LiDRON7/Drone-Construction/README.md

# Drone Construction

LiDRON's drone models and the parts we 3D print for them. Two drones: Widow (test drone) and Huntsman (carries the LiDAR).

## Widow

Storm Drone 6 V3. Parts, sizes and weights: [Widow README](3D%20Models/Widow/README.md).

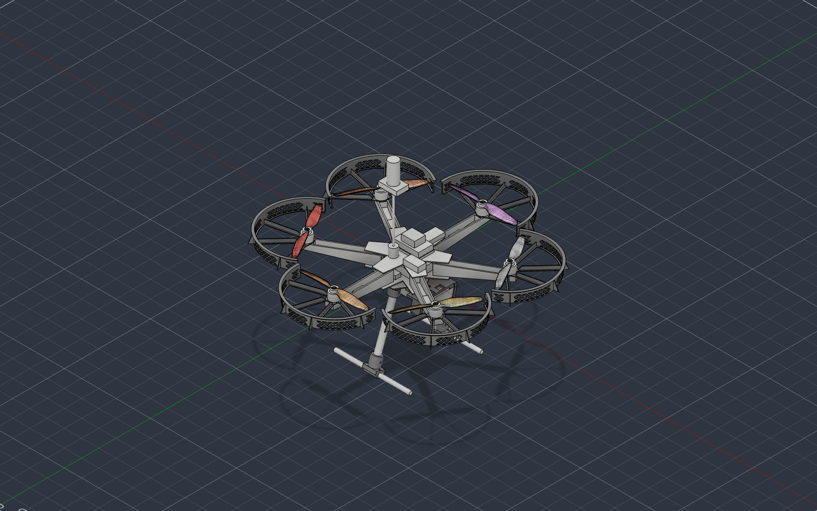
[picture p1: 3D Models/Widow/Full Drone/widow-full-drone-preview.png]
Widow, the whole drone
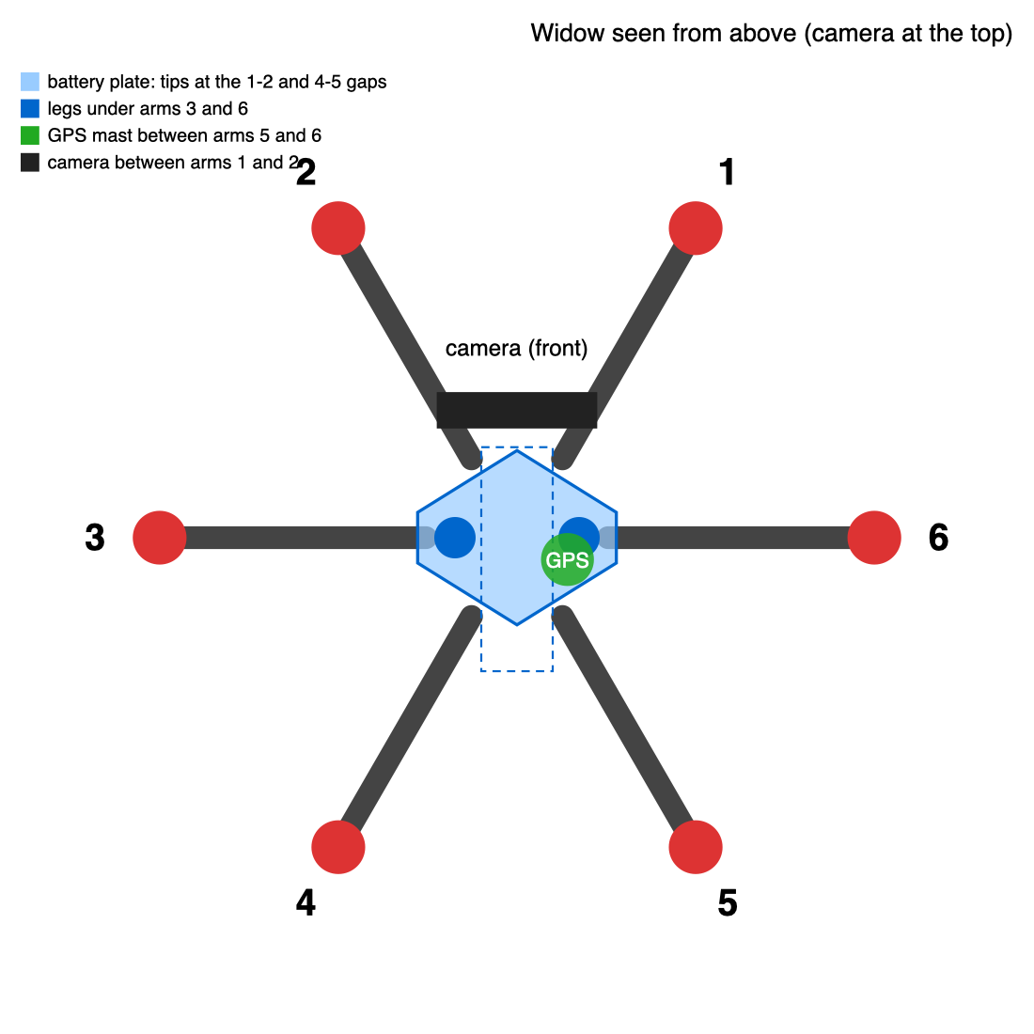
[picture p2: 3D Models/Widow/widow-top-view.png]
Widow from above, arms numbered
 

| Picture | Part | Print | What it does |
|---|---|---|---|
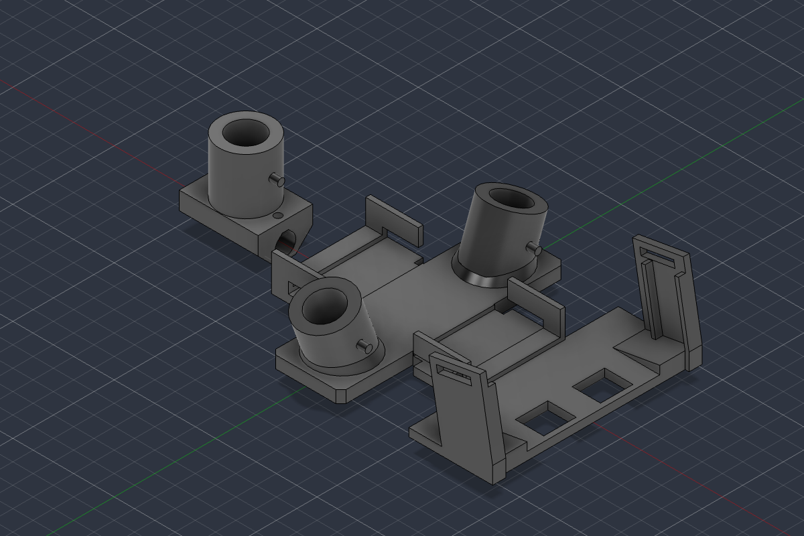
[picture p3: 3D Models/Widow/Printed Parts/Landing Leg/landing-leg-preview.png]
|  | [Landing Leg](3D%20Models/Widow/Printed%20Parts/Landing%20Leg) | 1 mount, 2 feet | Holds both legs, the battery and the camera |
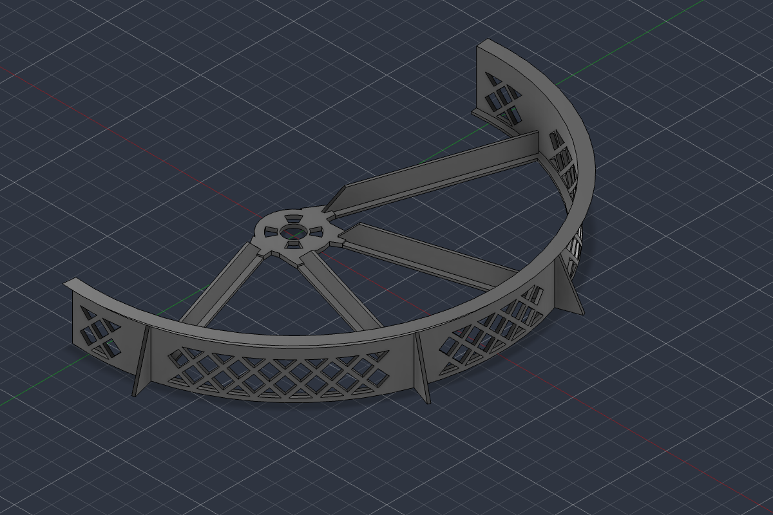
[picture p4: 3D Models/Widow/Printed Parts/Propeller Guard/propeller-guard-preview.png]
|  | [Propeller Guard](3D%20Models/Widow/Printed%20Parts/Propeller%20Guard) | 6 | One per prop, held by the motor screws |

## Huntsman

Tarot 680 PRO with the Velodyne Puck LITE. Parts, sizes, weights and LiDAR wiring: [Huntsman README](3D%20Models/Huntsman/README.md).

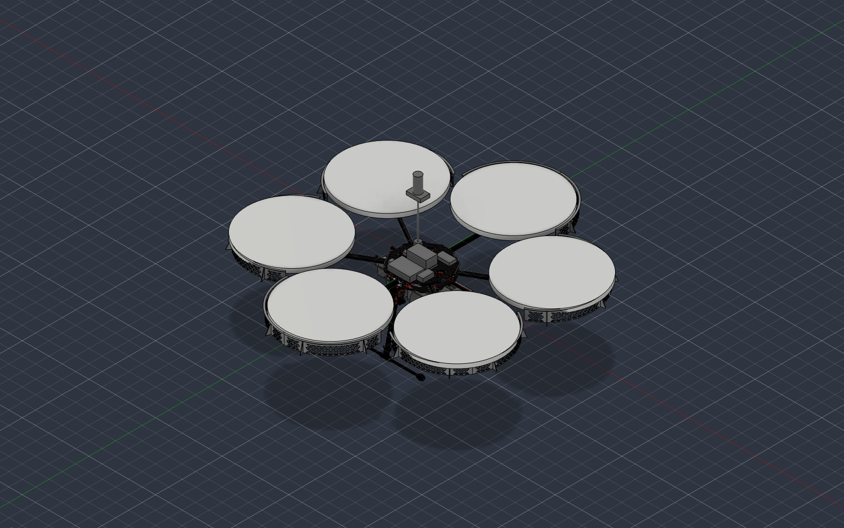
[picture p5: 3D Models/Huntsman/Full Drone/huntsman-full-drone-preview.png]
Huntsman, the whole drone


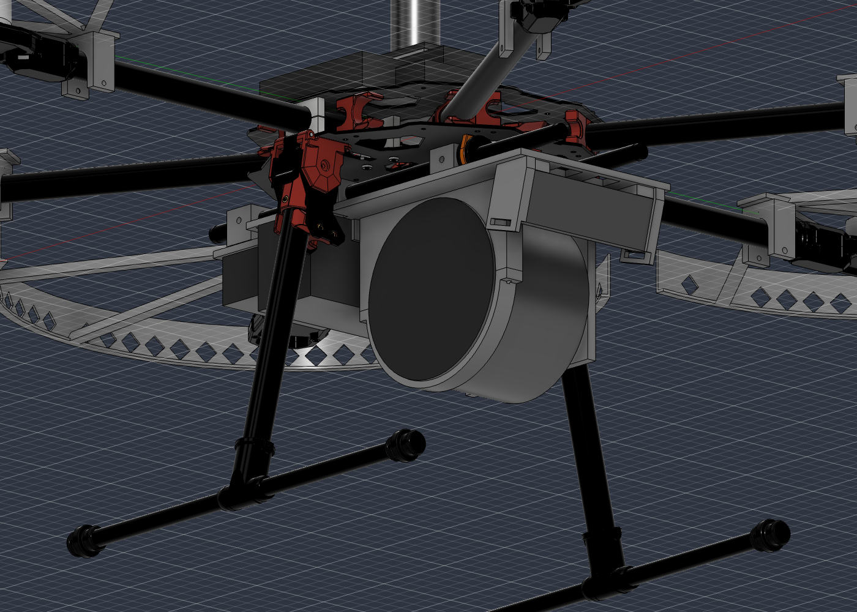
[picture p6: 3D Models/Huntsman/Full Drone/huntsman-payload-closeup.png]
Under Huntsman: LiDAR, battery and camera on the payload carrier
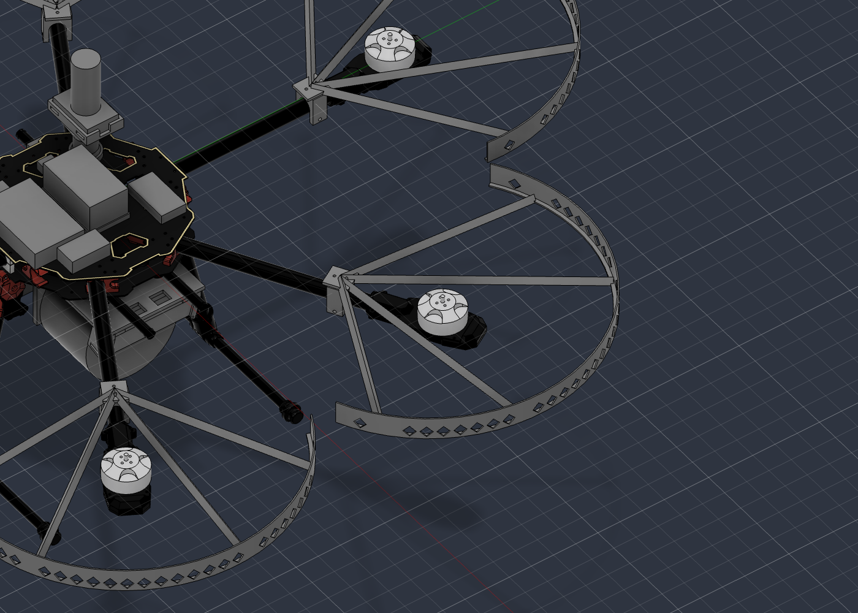
[picture p7: 3D Models/Huntsman/Full Drone/huntsman-guard-closeup.png]
Huntsman propeller guards on the arms
 

| Picture | Part | Print | What it does |
|---|---|---|---|
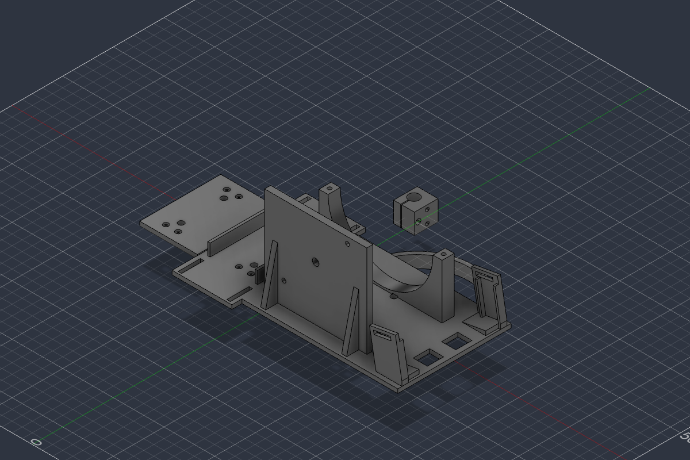
[picture p8: 3D Models/Huntsman/Printed Parts/Payload Carrier/payload-carrier-preview.png]
|  | [Payload Carrier](3D%20Models/Huntsman/Printed%20Parts/Payload%20Carrier) | 1 carrier, 1 interface-box plate, 1 LiDAR strap, 6 rod clamps | Hangs under the frame and holds the LiDAR, battery, camera and LiDAR interface box |
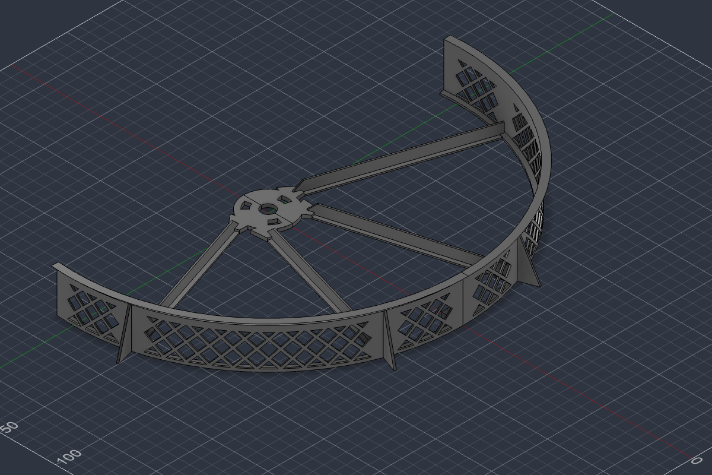
[picture p9: 3D Models/Huntsman/Printed Parts/Propeller Guard/propeller-guard-preview.png]
|  | [Propeller Guard](3D%20Models/Huntsman/Printed%20Parts/Propeller%20Guard) | 6 guards (2 halves each) | One per 13" prop, held under the motor by its screws |

We print on a Bambu Lab X2D (bed 256 x 256 mm). Propeller guards are PETG; Huntsman's payload carrier, rod clamps and LiDAR strap are PAHT-CF
(dry it first); everything else is PETG-CF. Use PLA only
for test prints.

## Print a part

Open the part's folder and pick a file:

- `.gcode.3mf` is sliced for the X2D: open it in Bambu Studio (or send it from Bambu Handy) and print. Pick the
  AMS slot with the right filament when it asks.
- `.stl` is for any other printer (click it on GitHub to spin it in 3D)
- `.step` opens in Fusion or any CAD program

## Upload a new or changed file

1. Open the folder the file belongs in.
2. Click Add file, then Upload files, and drag your files in.
3. Write one line about what changed, then click Commit changes.

Keep the same file name when you change a part. No `v2`, no `final`, no "old" folders. GitHub keeps every earlier version: open the file, click History, pick the change.

## Where things are

```
3D Models/
├── Widow/
│   ├── Printed Parts/     parts we print
│   ├── Reference Parts/   models of parts we buy, to design holders around
│   └── Full Drone/        everything put together
├── Huntsman/              same folders (Reference Parts has the Tarot 680 PRO frame)
└── Fusion Scripts/        the scripts that build the models
```

Reference parts start with their kind so they sort together: `frame-`, `propulsion-`, `power-`, `flight-controller-`,
`gps-`, `radio-`, `computer-`, `camera-`, `misc-`. Anything named `placeholder` is a rough block until we measure it.

## Change a part's size

Each part has a script in `Fusion Scripts` (`landing_leg.py` builds Widow's landing leg, `huntsman_*.py` build
Huntsman's parts). Sizes are at the top of each script. With Fusion open and the
[Fusion360MCP add-in](https://github.com/faust-machines/fusion360-mcp-server) running:

```
cd "3D Models/Fusion Scripts"
python3 run_in_fusion.py execute_code -code landing_leg.py
```

The scripts check strength and fit and stop with a message if something is off. Then run `full_drone.py` (or
`huntsman_full_drone.py`) so the whole drone picks up the change.

Stuck? Ask Alex or Devlin.
