LiDRON7/Drone-Construction/3D Models/FEA/guard-bump-between.png

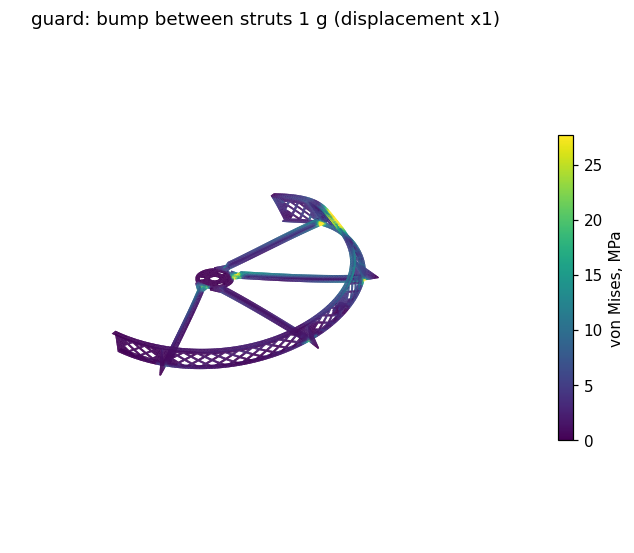
3D Models/FEA/guard-bump-between.png
