LiDRON7/Drone-Construction/3D Models/FEA/guard-front-bump.png

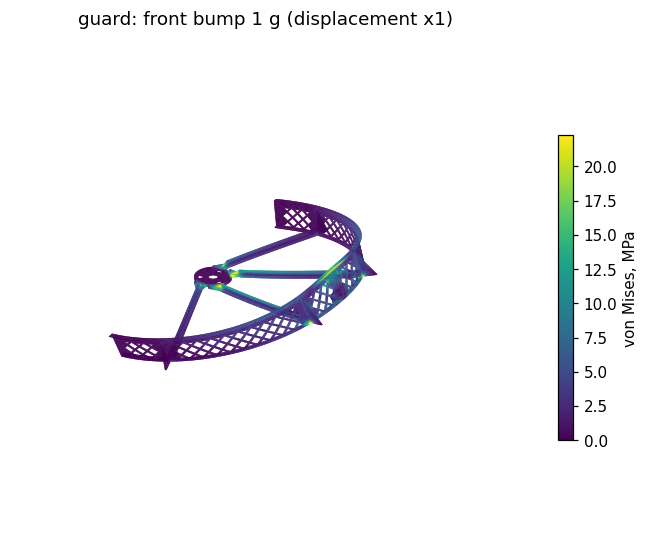
3D Models/FEA/guard-front-bump.png
