LiDRON7/Drone-Construction/3D Models/FEA/widow_guard-front-bump.png

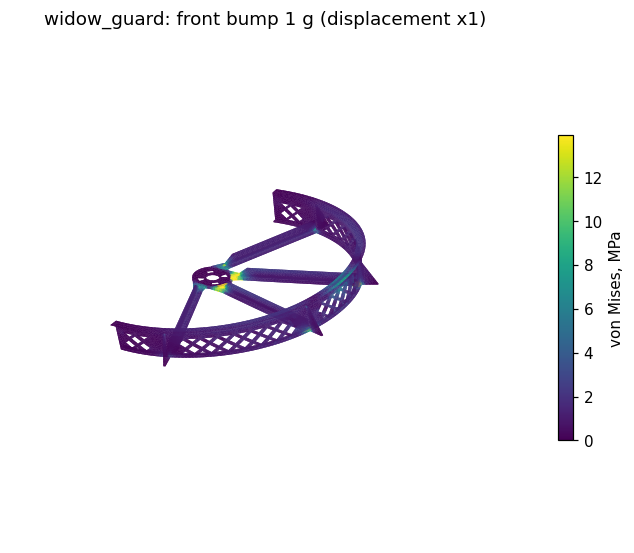
3D Models/FEA/widow_guard-front-bump.png
