LiDRON7/Drone-Construction/3D Models/FEA/widow_guard-side-bump.png

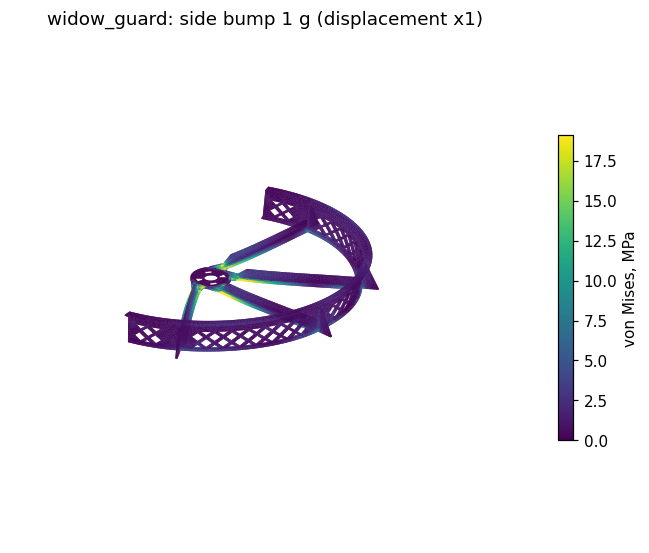
3D Models/FEA/widow_guard-side-bump.png
