LiDRON7/Drone-Construction/3D Models/Huntsman/Full Drone/huntsman-side-view.png

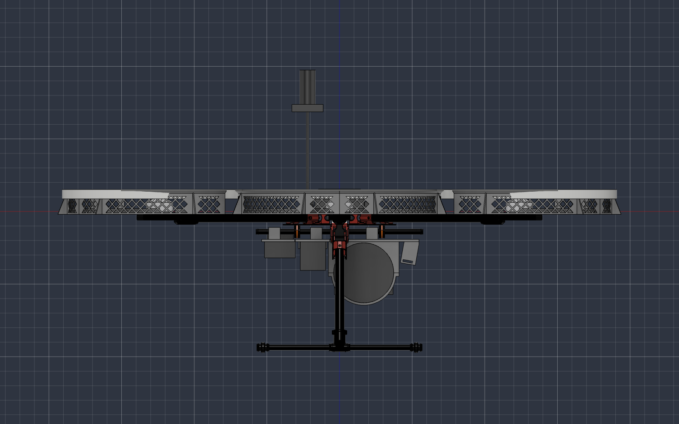
3D Models/Huntsman/Full Drone/huntsman-side-view.png
