LiDRON7/Drone-Construction/docs/proof/35-thrust-est.png

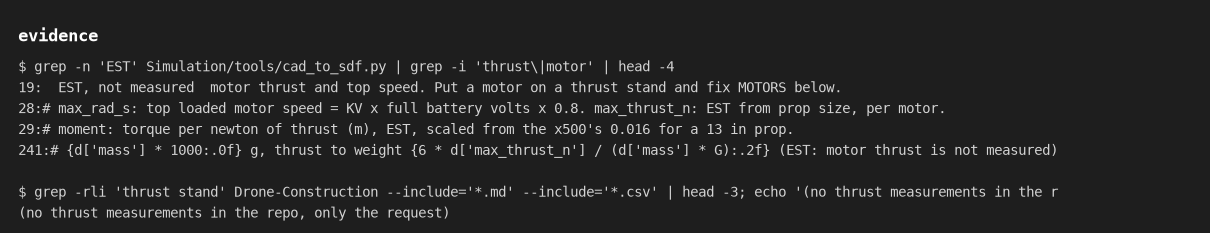
docs/proof/35-thrust-est.png
