LiDRON7/Drone-Construction/docs/proof/36-git-size.png

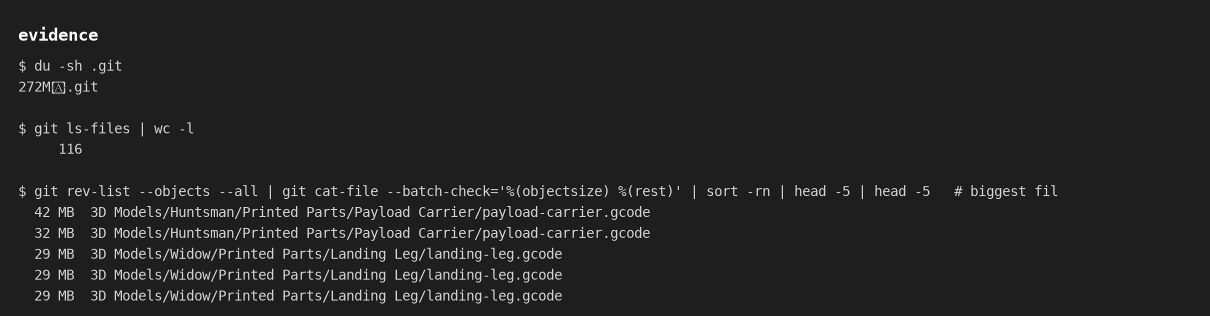
docs/proof/36-git-size.png
