LiDRON7/Drone-Construction/docs/proof/37-helpers.png

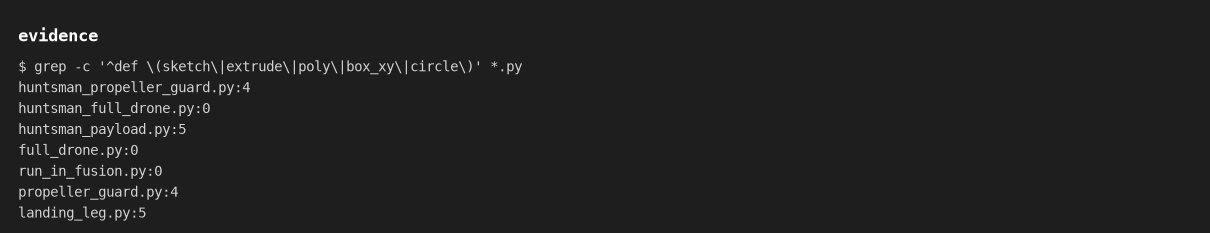
docs/proof/37-helpers.png
