LiDRON7/Drone-Construction/3D Models/Widow/Printed Parts/GPS Mast/gps-mast-preview.png

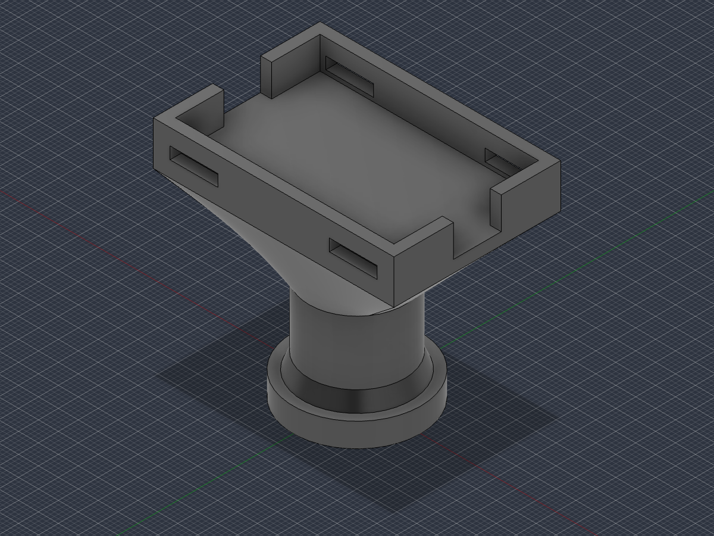
3D Models/Widow/Printed Parts/GPS Mast/gps-mast-preview.png
