LiDRON7/Drone-Construction/3D Models/Widow/Printed Parts/Rain Cover/rain-cover-preview.png

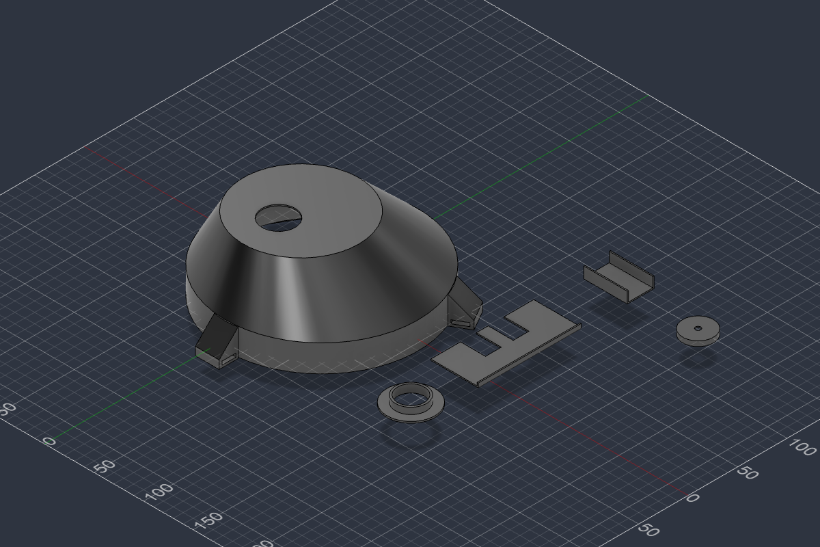
3D Models/Widow/Printed Parts/Rain Cover/rain-cover-preview.png
