LiDRON7/Drone-Construction/3D Models/Widow/Full Drone/widow-full-drone.step

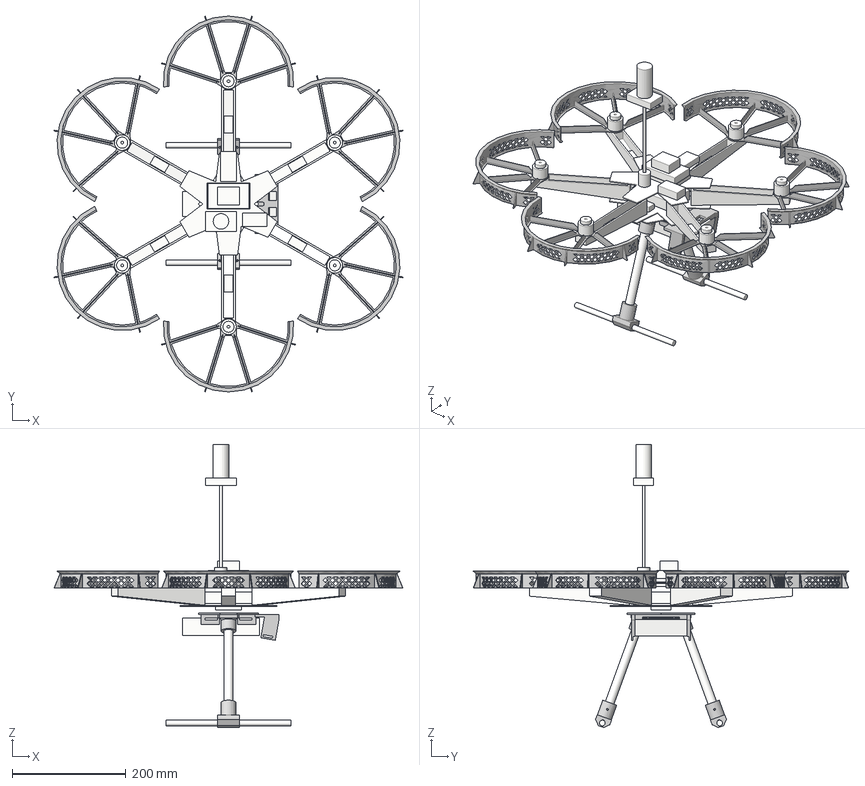
[picture p21: CAD file, 2026-11-13]
3D Models/Widow/Full Drone/widow-full-drone.step
614.1 x 661.4 x 498.2 mm
