LiDRON7/Drone-Construction/3D Models/Huntsman/Printed Parts/Payload Carrier/interface-box-plate.stl

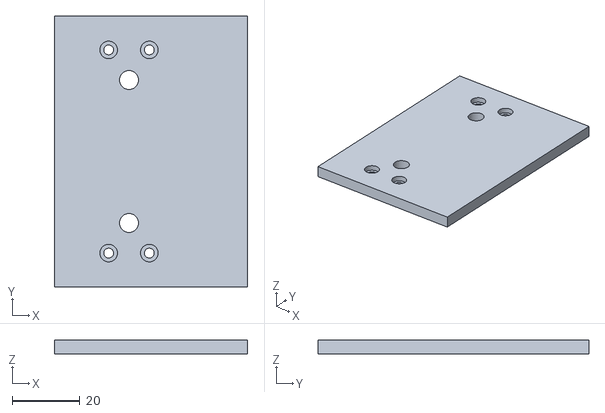
[picture p22: CAD file, 2026-11-12]
3D Models/Huntsman/Printed Parts/Payload Carrier/interface-box-plate.stl
57.0 x 80.0 x 4.00
