LiDRON7/Drone-Construction/3D Models/Huntsman/Printed Parts/Propeller Guard/propeller-guard.step

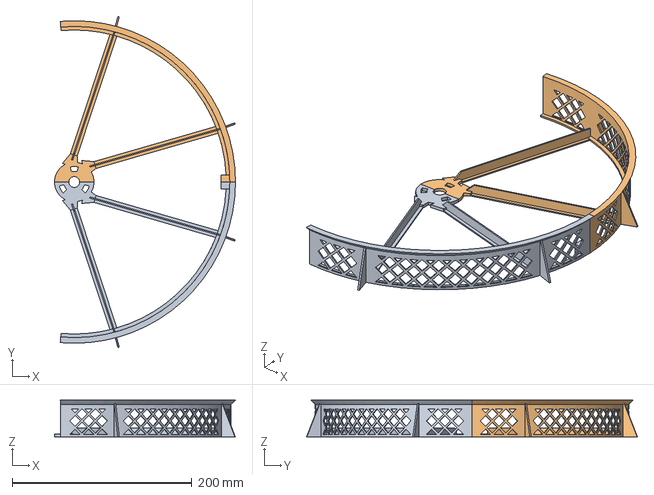
[picture p23: CAD file, 2026-11-12]
3D Models/Huntsman/Printed Parts/Propeller Guard/propeller-guard.step
201.4 x 368.3 x 40.8 mm
