LiDRON7/Drone-Construction/3D Models/Huntsman/Printed Parts/Rain Cover/rain-canopy.gcode.3mf

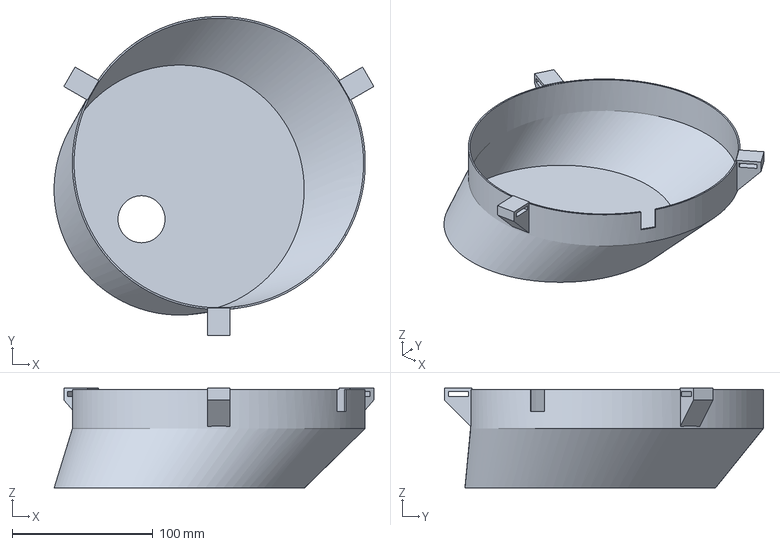
[picture p24: CAD file, 2026-11-12]
3D Models/Huntsman/Printed Parts/Rain Cover/rain-canopy.gcode.3mf
227.4 x 226.9 x 70.8 mm
