LiDRON7/Drone-Construction/3D Models/Huntsman/Reference Parts/frame-tarot-680-pro.step

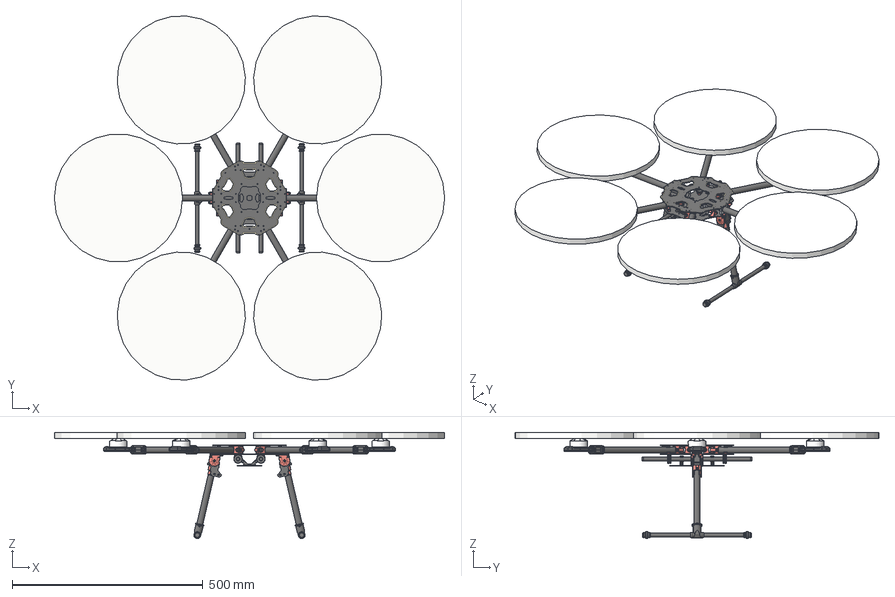
[picture p25: CAD file, 2026-11-10]
3D Models/Huntsman/Reference Parts/frame-tarot-680-pro.step
1022.8 x 953.7 x 278.3 mm
20021-001_plate1
94100A160 x 4
94180A321_2 x 40
94180A321_1 x 6
94180A323 x 12
20021-005_arm x 6
20021-006_arm-clamp x 8
91585A356 x 2
94180A321 x 8
20021-010_leg x 2
20021-011_landing-gear-connector x 2
20021-012_small-tube x 4
20021-013_landing-gear-foot x 4
20021-014,015_vibration-damper x 4
20021-016_payload-rod-cap x 4
20021-017_payload-deck
20021-018_payload-deck-clip x 2
94180A321_3 x 36
20021-022_motor x 6
20021-023_propeller x 6
