LiDRON7/Drone-Construction/3D Models/Widow/Printed Parts/GPS Mast/gps-mast.gcode.3mf

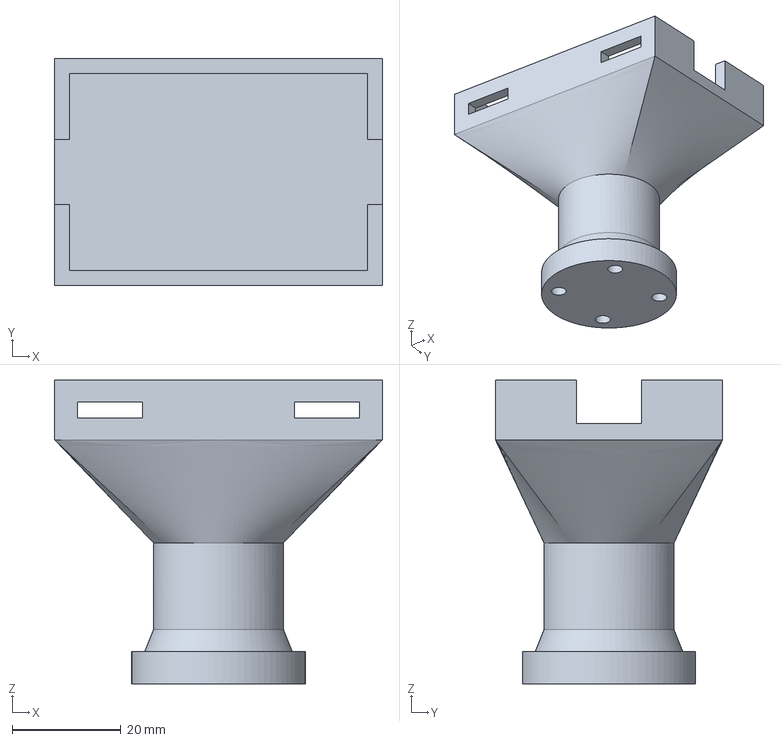
[picture p26: CAD file, 2026-11-12]
3D Models/Widow/Printed Parts/GPS Mast/gps-mast.gcode.3mf
60.5 x 41.9 x 56.0 mm
