LiDRON7/Drone-Construction/3D Models/Widow/Printed Parts/Landing Leg/landing-leg-mount.step

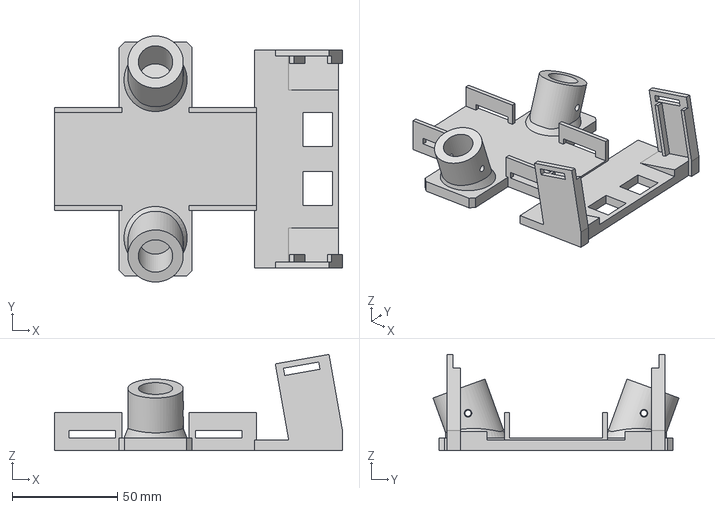
[picture p27: CAD file, 2026-11-12]
3D Models/Widow/Printed Parts/Landing Leg/landing-leg-mount.step
136.8 x 116.9 x 45.7 mm
