LiDRON7/Drone-Construction/3D Models/Widow/Printed Parts/Propeller Guard/propeller-guard.step

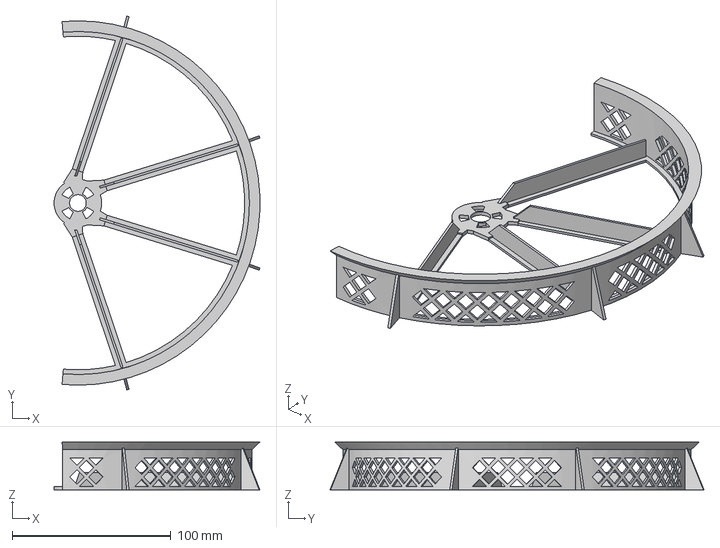
[picture p28: CAD file, 2026-11-12]
3D Models/Widow/Printed Parts/Propeller Guard/propeller-guard.step
129.6 x 235.5 x 30.0 mm
