LiDRON7/Drone-Construction/3D Models/Widow/Printed Parts/Rain Cover/camera-visor.step

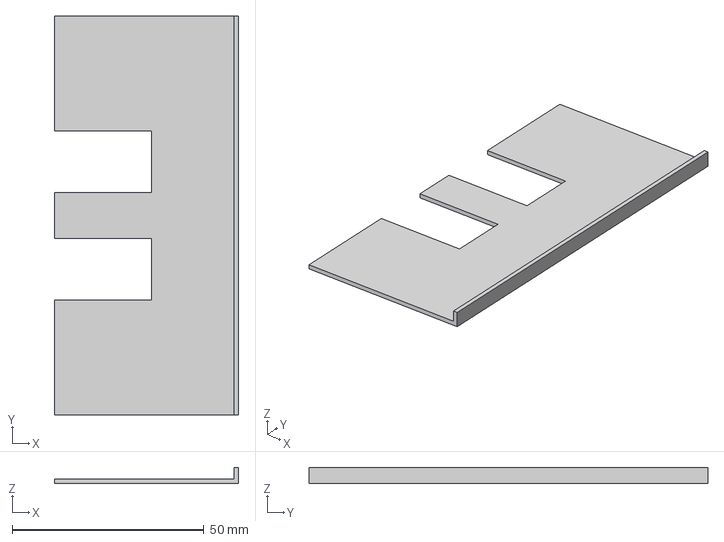
[picture p29: CAD file, 2026-11-12]
3D Models/Widow/Printed Parts/Rain Cover/camera-visor.step
48.0 x 104.0 x 4.20 mm
