LiDRON7/Drone-Construction/3D Models/Widow/Reference Parts/gps-metal-stand-rod.step

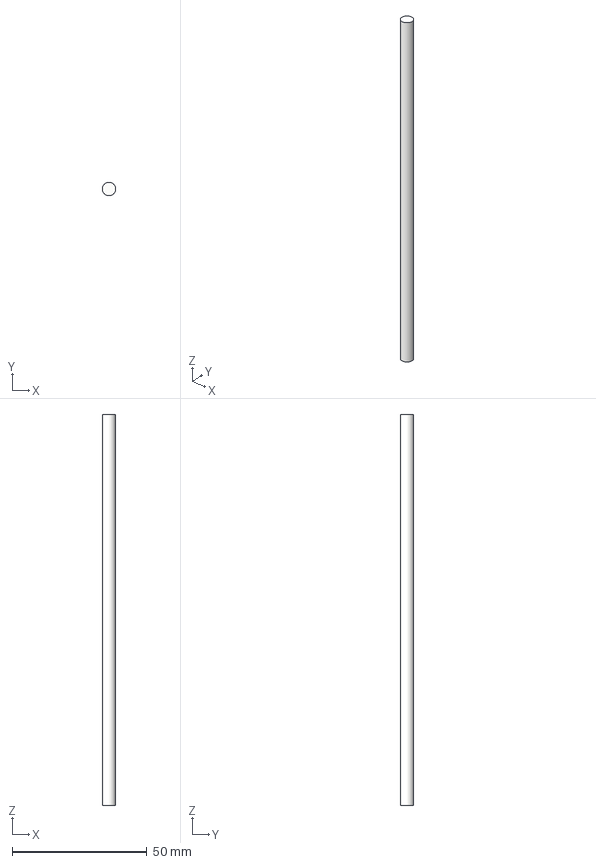
[picture p30: CAD file, 2026-11-13]
3D Models/Widow/Reference Parts/gps-metal-stand-rod.step
5.00 x 5.00 x 145.0 mm
