LiDRON7/Drone-Construction/3D Models/Huntsman/Printed Parts/Payload Carrier/payload-carrier.gcode.3mf

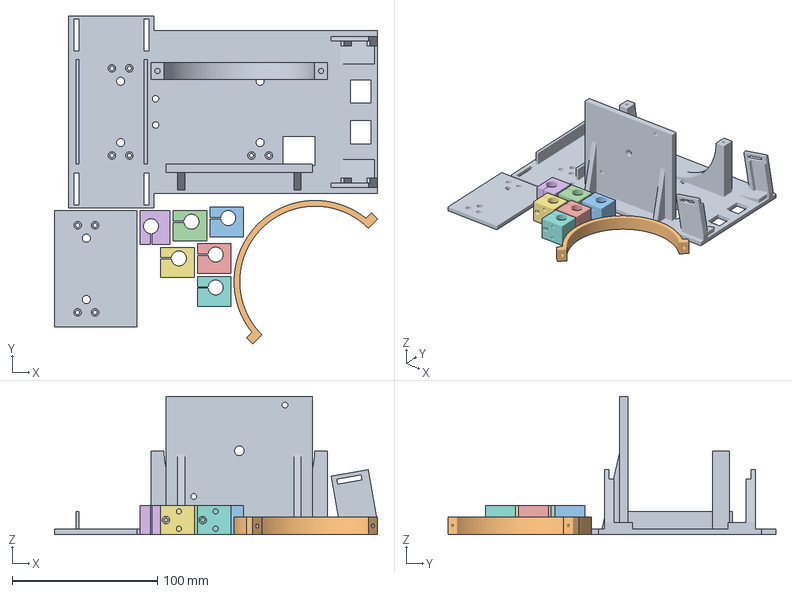
[picture p31: CAD file, 2026-11-12]
3D Models/Huntsman/Printed Parts/Payload Carrier/payload-carrier.gcode.3mf
222.4 x 225.7 x 95.1 mm
payload-carrier.stl
lidar-strap.stl
rod-clamp.stl x 6
interface-box-plate.stl
