LiDRON7/Drone-Construction/3D Models/Huntsman/Printed Parts/Propeller Guard/propeller-guard-left.gcode.3mf

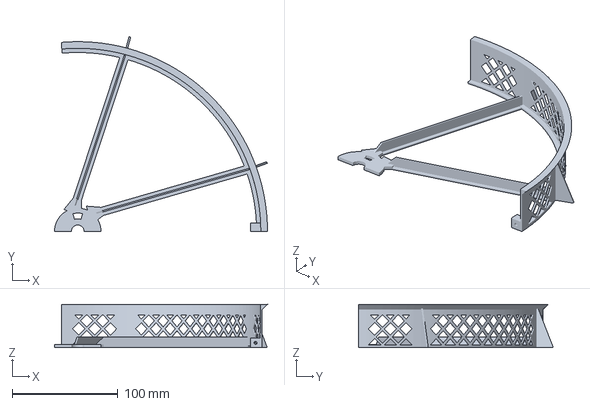
[picture p32: CAD file, 2026-11-12]
3D Models/Huntsman/Printed Parts/Propeller Guard/propeller-guard-left.gcode.3mf
201.4 x 184.1 x 40.8 mm
