LiDRON7/Drone-Construction/3D Models/Huntsman/Printed Parts/Rain Cover/interface-box-cover.step

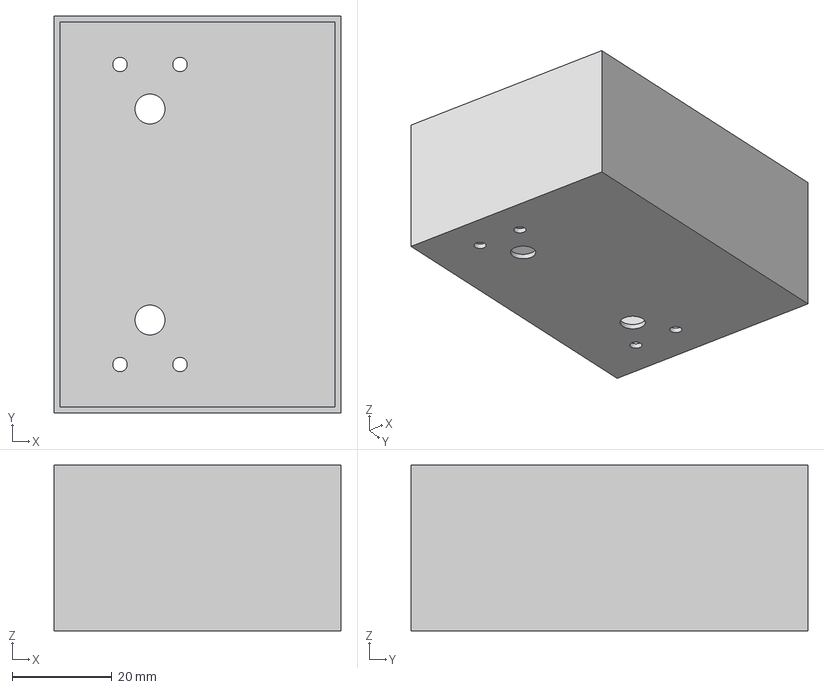
[picture p33: CAD file, 2026-11-12]
3D Models/Huntsman/Printed Parts/Rain Cover/interface-box-cover.step
57.4 x 79.4 x 33.2 mm
