LiDRON7/Drone-Construction/3D Models/Widow/Printed Parts/Landing Leg/landing-leg-foot.step

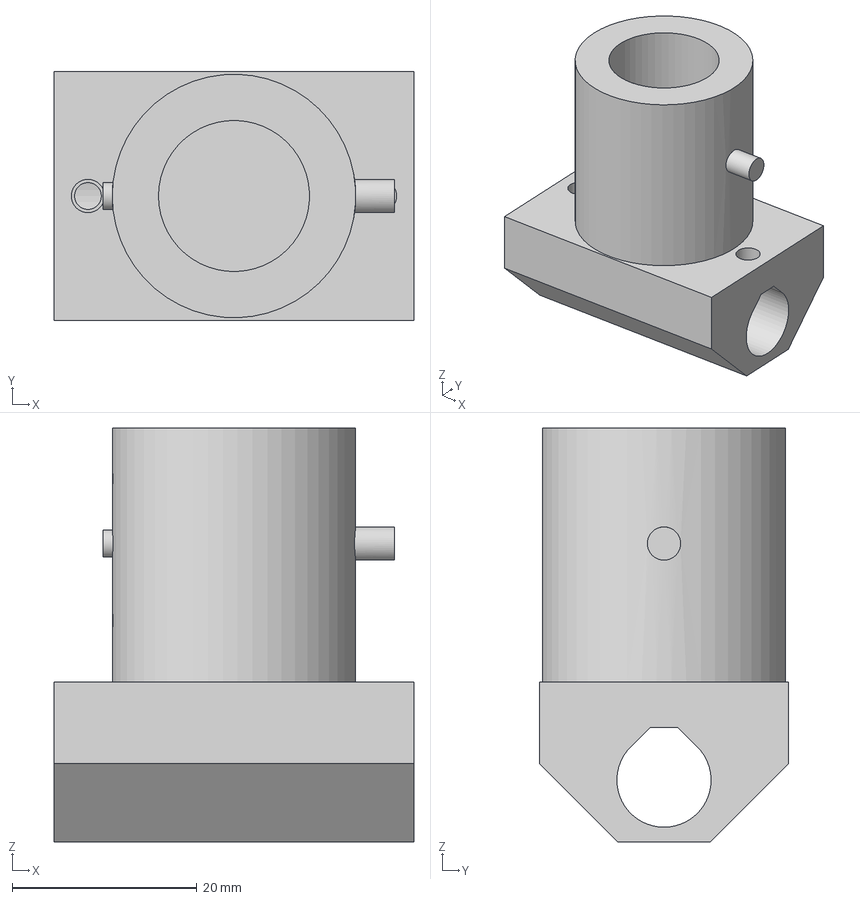
[picture p34: CAD file, 2026-11-10]
3D Models/Widow/Printed Parts/Landing Leg/landing-leg-foot.step
38.9 x 26.9 x 44.8 mm
