LiDRON7/Drone-Construction/3D Models/Widow/Printed Parts/Rain Cover/esc-covers-motor-caps-visor.gcode.3mf

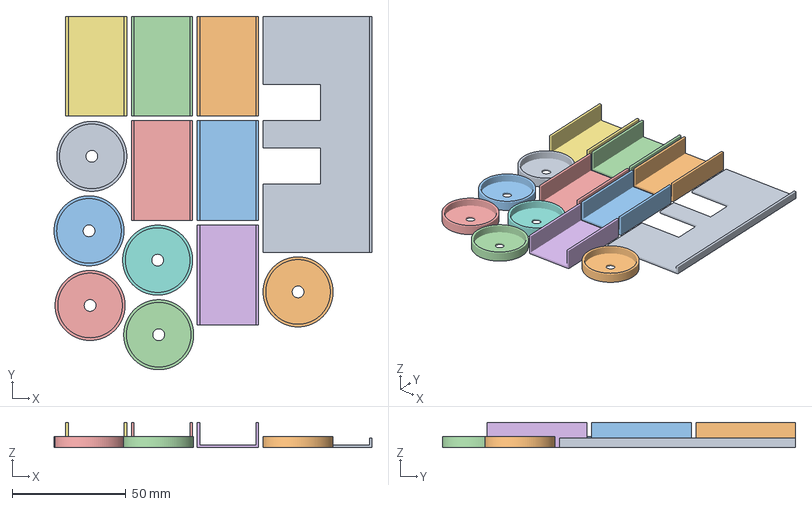
[picture p35: CAD file, 2026-11-12]
3D Models/Widow/Printed Parts/Rain Cover/esc-covers-motor-caps-visor.gcode.3mf
140.1 x 155.7 x 11.2 mm
camera-visor.stl
set-w-esc1.stl
set-w-esc2.stl
set-w-esc3.stl
set-w-esc4.stl
set-w-esc5.stl
set-w-esc6.stl
set-w-cap1.stl
set-w-cap2.stl
set-w-cap3.stl
set-w-cap4.stl
set-w-cap5.stl
set-w-cap6.stl
