LiDRON7/Drone-Construction/3D Models/Widow/Reference Parts/gps-metal-stand-base.step

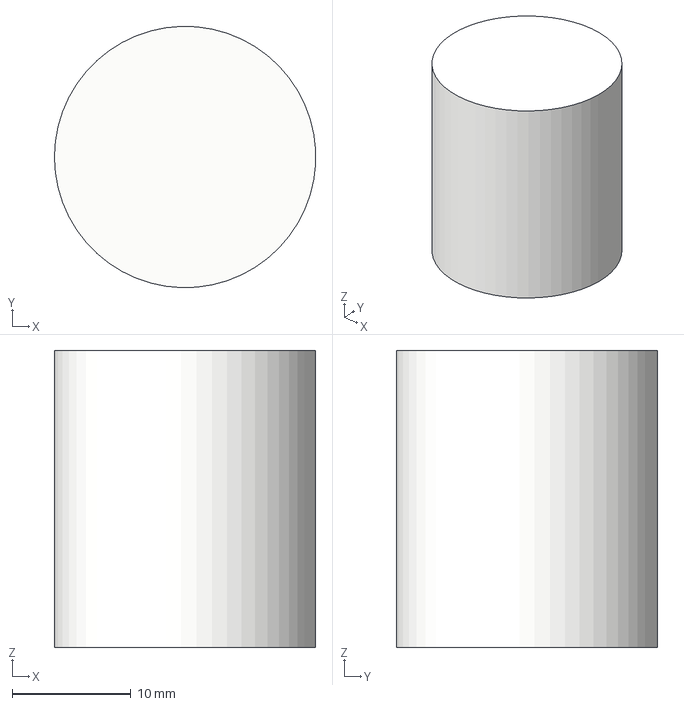
[picture p36: CAD file, 2026-11-13]
3D Models/Widow/Reference Parts/gps-metal-stand-base.step
22.0 x 22.0 x 25.0 mm
