LiDRON7/Drone-Construction/3D Models/Huntsman/Printed Parts/Payload Carrier/rod-clamp.step

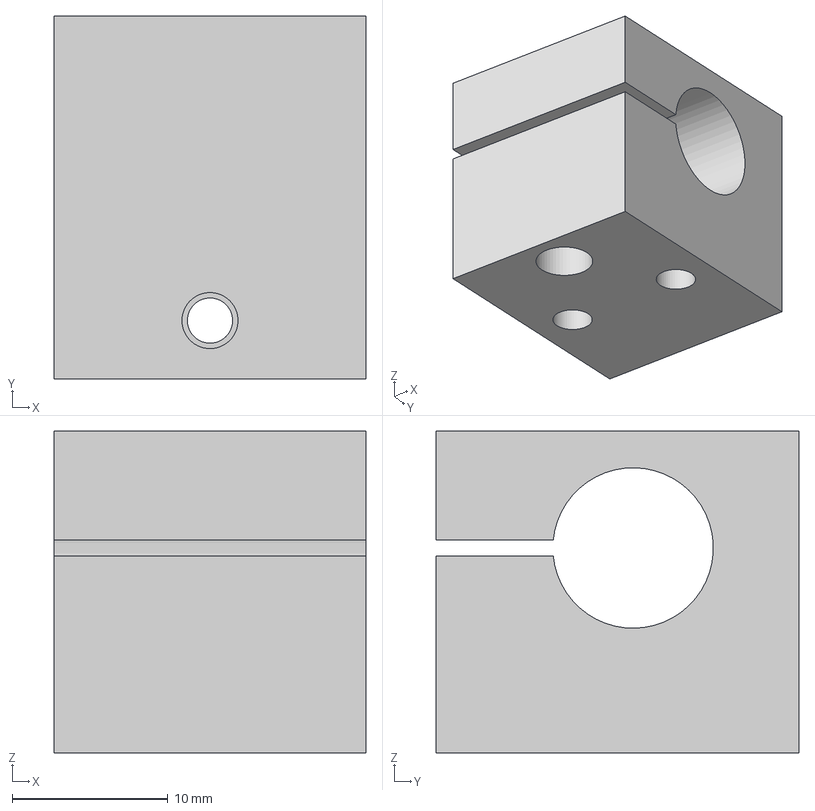
[picture p37: CAD file, 2026-11-12]
3D Models/Huntsman/Printed Parts/Payload Carrier/rod-clamp.step
20.0 x 23.3 x 20.6 mm
