LiDRON7/Drone-Construction/3D Models/Huntsman/Printed Parts/Rain Cover/esc-covers-motor-caps-box-cover.gcode.3mf

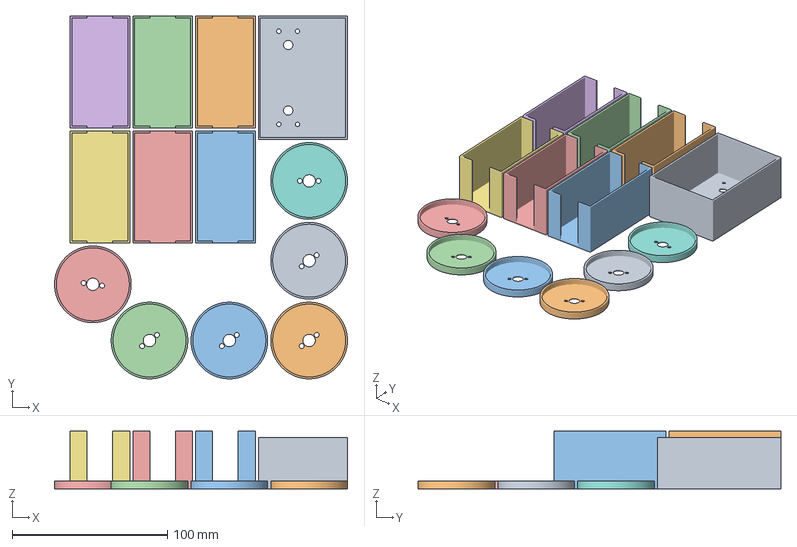
[picture p38: CAD file, 2026-11-12]
3D Models/Huntsman/Printed Parts/Rain Cover/esc-covers-motor-caps-box-cover.gcode.3mf
188.7 x 233.6 x 37.2 mm
interface-box-cover.stl
set-h-esc1.stl
set-h-esc2.stl
set-h-esc3.stl
set-h-esc4.stl
set-h-esc5.stl
set-h-esc6.stl
set-h-cap1.stl
set-h-cap2.stl
set-h-cap3.stl
set-h-cap4.stl
set-h-cap5.stl
set-h-cap6.stl
