LiDRON7/Drone-Construction/3D Models/Widow/Printed Parts/Landing Leg/landing-leg-x2.3mf

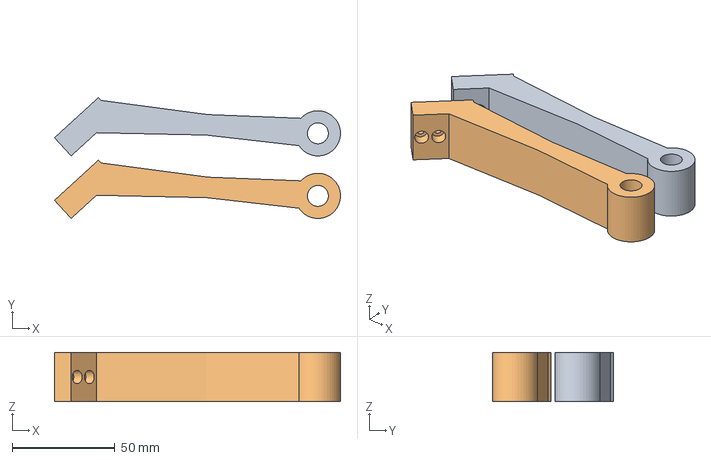
[picture p39: CAD file, 2026-11-07]
3D Models/Widow/Printed Parts/Landing Leg/landing-leg-x2.3mf
139.2 x 58.9 x 24.0 mm
widow-landing-leg-v3.stl_1
widow-landing-leg-v3.stl_2
