LiDRON7/Drone-Construction/3D Models/Widow/Printed Parts/Rain Cover/esc-cover.step

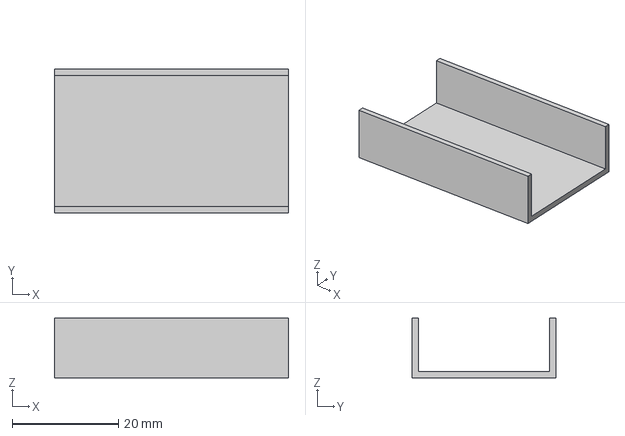
[picture p40: CAD file, 2026-11-12]
3D Models/Widow/Printed Parts/Rain Cover/esc-cover.step
44.0 x 27.0 x 11.2 mm
