LiDRON7/Drone-Construction/3D Models/Widow/Reference Parts/frame-top-plate.step

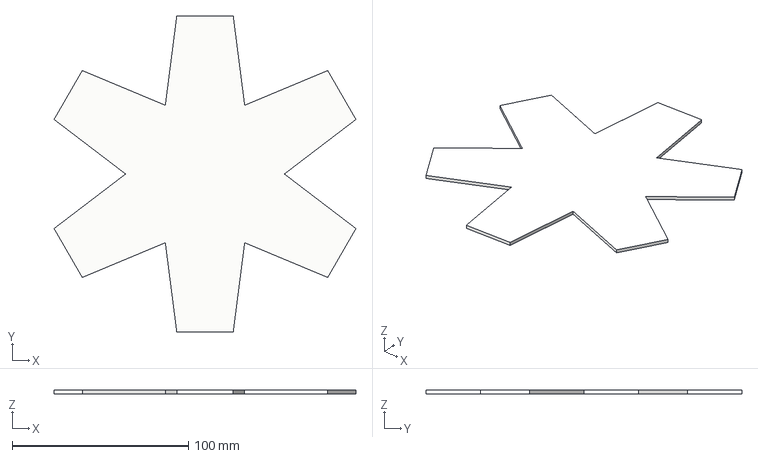
[picture p41: CAD file, 2026-11-12]
3D Models/Widow/Reference Parts/frame-top-plate.step
171.2 x 179.2 x 2.00 mm
