LiDRON7/Drone-Construction/3D Models/Huntsman/Printed Parts/Payload Carrier/payload-carrier.step

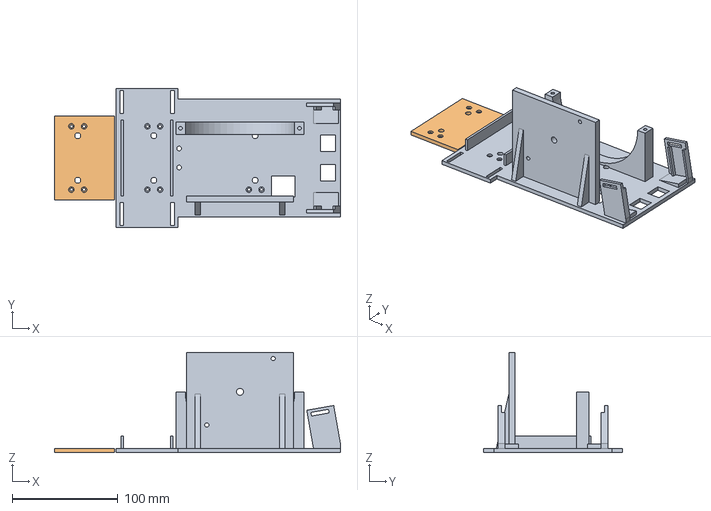
[picture p42: CAD file, 2026-11-12]
3D Models/Huntsman/Printed Parts/Payload Carrier/payload-carrier.step
270.8 x 132.0 x 95.1 mm
