LiDRON7/Drone-Construction/3D Models/Huntsman/Printed Parts/Rain Cover/motor-cap.step

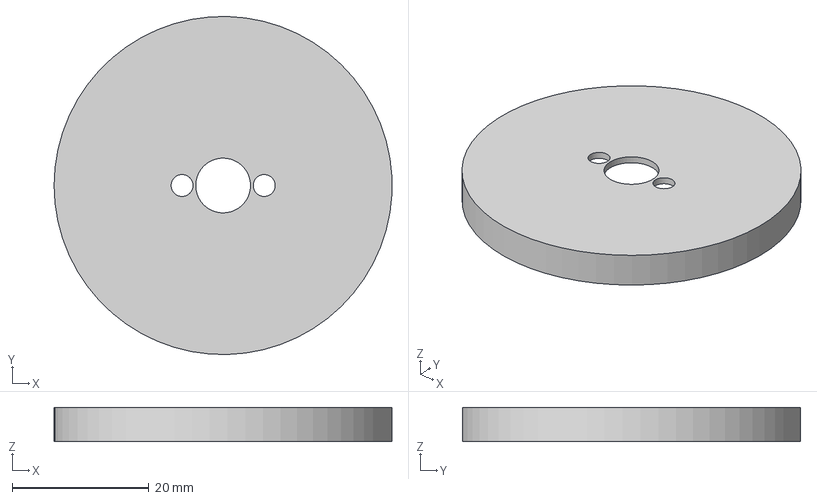
[picture p43: CAD file, 2026-11-12]
3D Models/Huntsman/Printed Parts/Rain Cover/motor-cap.step
49.4 x 49.4 x 5.00 mm
