LiDRON7/Drone-Construction/3D Models/Widow/Printed Parts/Landing Leg/landing-leg.step

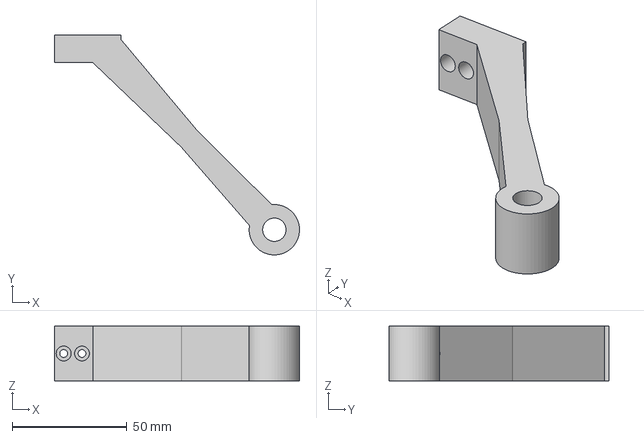
[picture p44: CAD file, 2026-11-07]
3D Models/Widow/Printed Parts/Landing Leg/landing-leg.step
107.0 x 96.0 x 24.0 mm
