LiDRON7/Drone-Construction/3D Models/Widow/Printed Parts/Rain Cover/antenna-collar.gcode.3mf

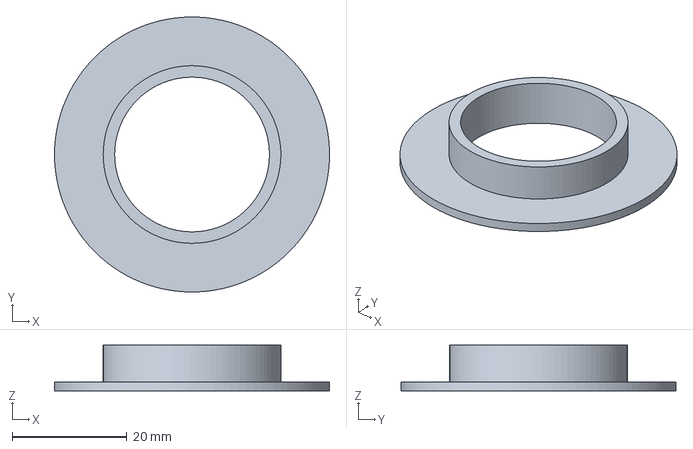
[picture p45: CAD file, 2026-11-12]
3D Models/Widow/Printed Parts/Rain Cover/antenna-collar.gcode.3mf
48.0 x 48.0 x 8.00 mm
