LiDRON7/Drone-Construction/3D Models/Widow/Reference Parts/frame-battery-plate.step

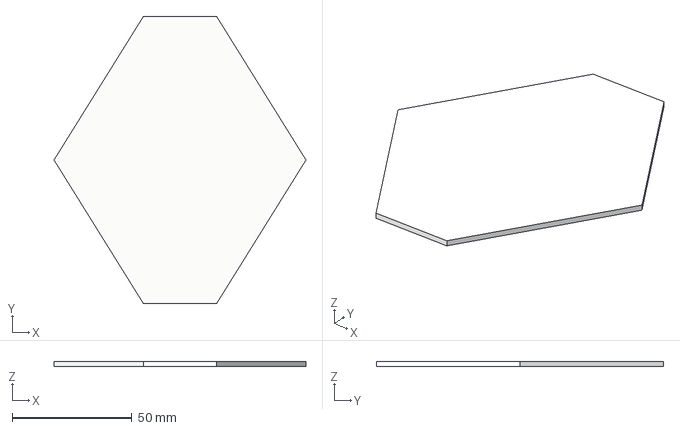
[picture p46: CAD file, 2026-11-12]
3D Models/Widow/Reference Parts/frame-battery-plate.step
105.4 x 120.1 x 2.00 mm
