LiDRON7/Drone-Construction/3D Models/Huntsman/Printed Parts/Payload Carrier/lidar-strap.step

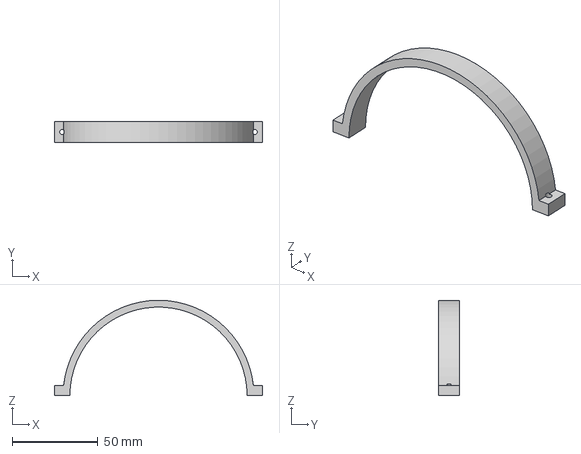
[picture p47: CAD file, 2026-11-10]
3D Models/Huntsman/Printed Parts/Payload Carrier/lidar-strap.step
121.6 x 12.0 x 55.8 mm
