LiDRON7/Drone-Construction/3D Models/Huntsman/Printed Parts/Propeller Guard/arm-clamp.step

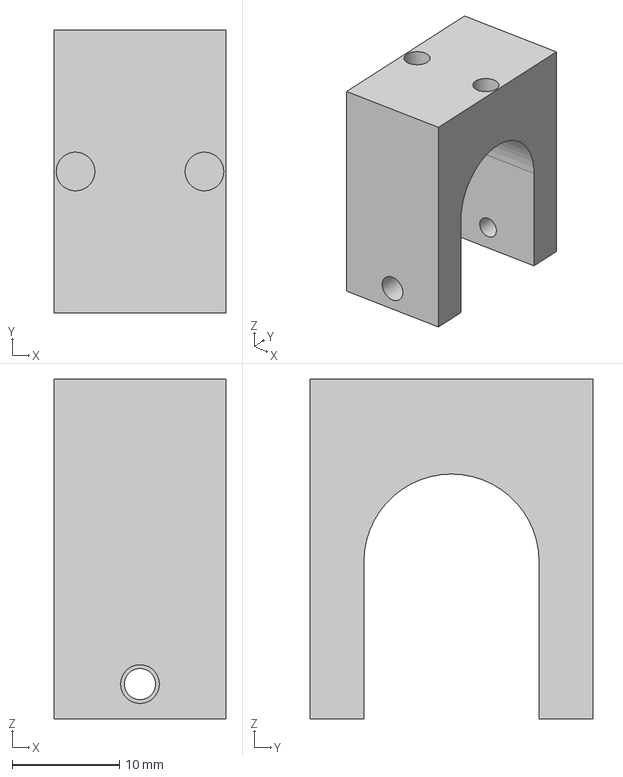
[picture p48: CAD file, 2026-11-10]
3D Models/Huntsman/Printed Parts/Propeller Guard/arm-clamp.step
16.0 x 26.3 x 31.6 mm
