LiDRON7/Drone-Construction/3D Models/Widow/Printed Parts/Rain Cover/motor-cap.step

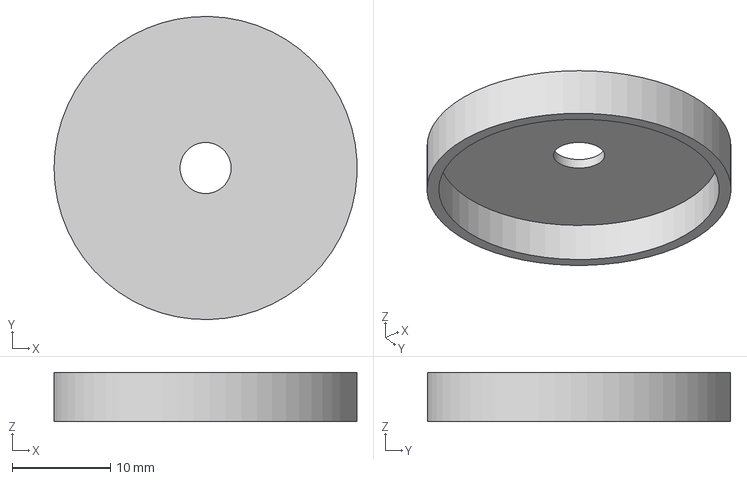
[picture p49: CAD file, 2026-11-12]
3D Models/Widow/Printed Parts/Rain Cover/motor-cap.step
30.8 x 30.9 x 5.00 mm
