LiDRON7/Drone-Construction/3D Models/Widow/Reference Parts/misc-wiring-bundle-placeholder.step

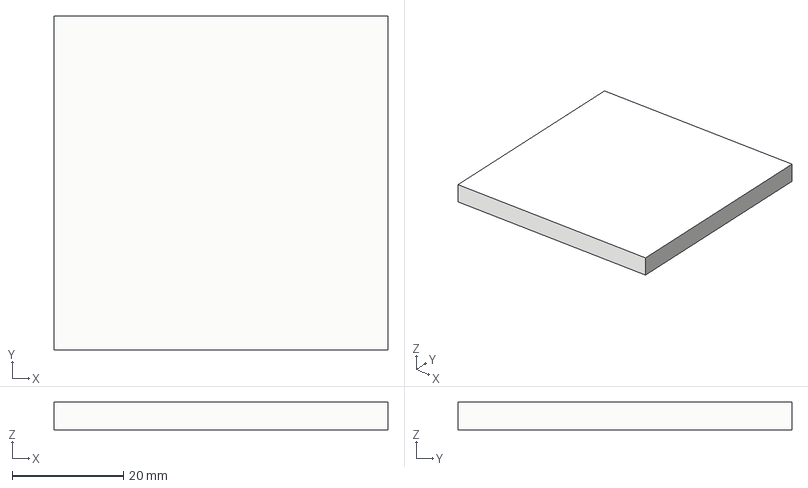
[picture p50: CAD file, 2026-11-12]
3D Models/Widow/Reference Parts/misc-wiring-bundle-placeholder.step
60.0 x 60.0 x 5.00 mm
