LiDRON7/Drone-Construction/3D Models/Huntsman/Printed Parts/Rain Cover/esc-cover.step

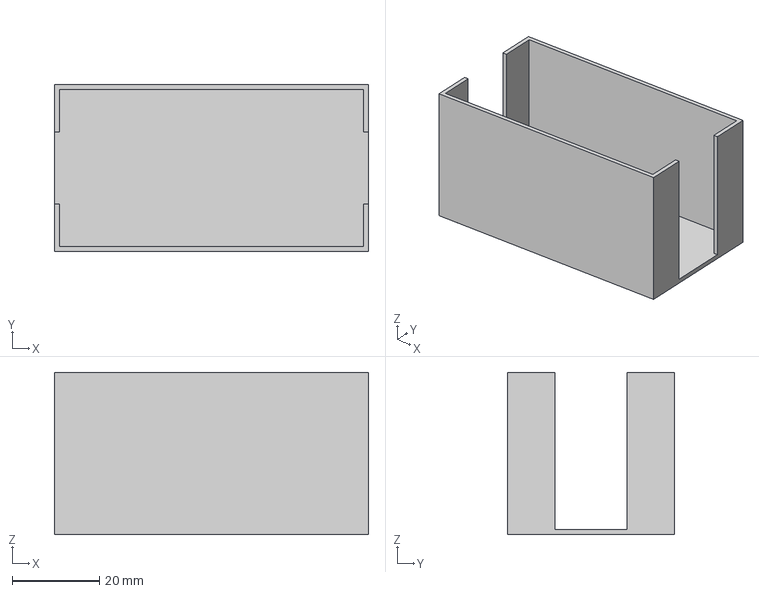
[picture p51: CAD file, 2026-11-12]
3D Models/Huntsman/Printed Parts/Rain Cover/esc-cover.step
72.0 x 38.4 x 37.2 mm
