LiDRON7/Drone-Construction/3D Models/Widow/Reference Parts/power-distribution-board.step

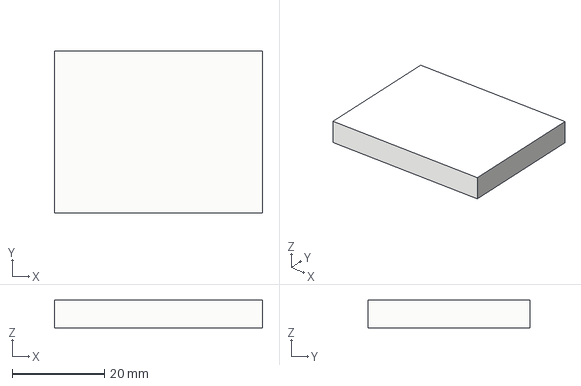
[picture p52: CAD file, 2026-11-12]
3D Models/Widow/Reference Parts/power-distribution-board.step
45.0 x 35.0 x 6.00 mm
