LiDRON7/Drone-Construction/3D Models/Widow/Printed Parts/Rain Cover/rain-canopy.step

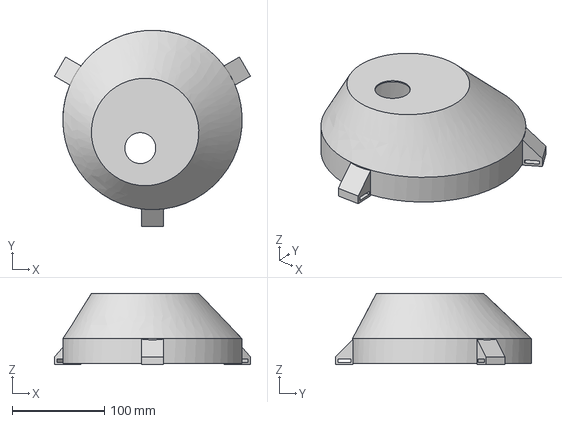
[picture p53: CAD file, 2026-11-12]
3D Models/Widow/Printed Parts/Rain Cover/rain-canopy.step
212.4 x 212.9 x 77.3 mm
