LiDRON7/Drone-Construction/3D Models/Widow/Reference Parts/power-battery-3s-5500mah-lipo.step

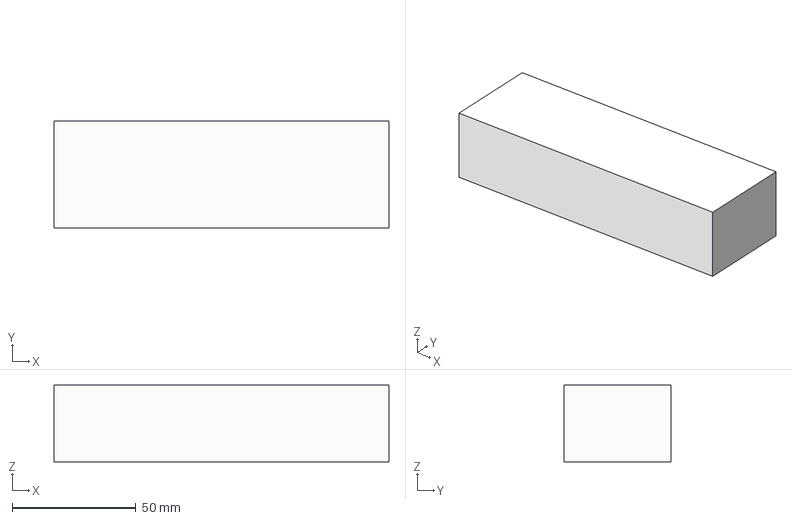
[picture p54: CAD file, 2026-11-12]
3D Models/Widow/Reference Parts/power-battery-3s-5500mah-lipo.step
135.4 x 43.2 x 31.1 mm
