LiDRON7/Drone-Construction/3D Models/Widow/Reference Parts/flight-controller-pixhawk-6x-mini-baseboard.step

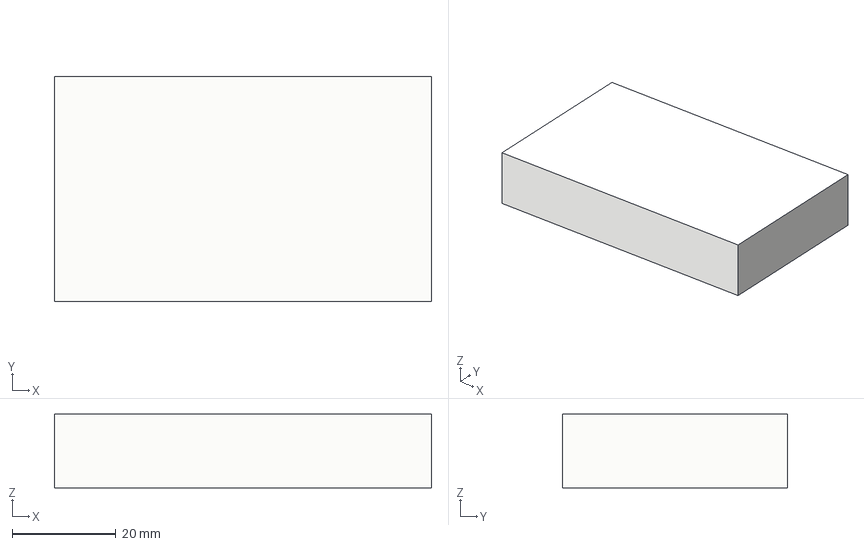
[picture p55: CAD file, 2026-11-12]
3D Models/Widow/Reference Parts/flight-controller-pixhawk-6x-mini-baseboard.step
72.8 x 43.4 x 14.2 mm
