LiDRON7/Drone-Construction/3D Models/Widow/Reference Parts/frame-arm.step

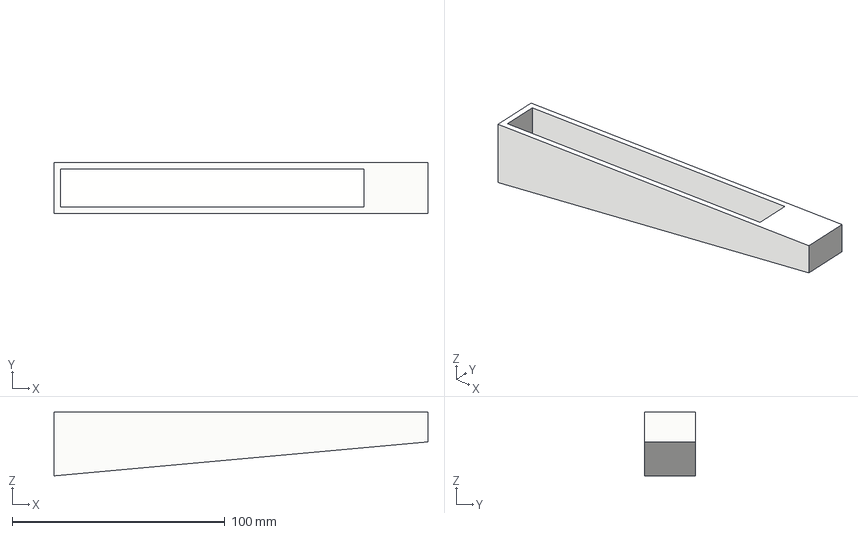
[picture p56: CAD file, 2026-11-12]
3D Models/Widow/Reference Parts/frame-arm.step
176.0 x 24.0 x 30.0 mm
