LiDRON7/Drone-Construction/3D Models/Widow/Reference Parts/camera-luxonis-oak-d-pro-heatsink.step

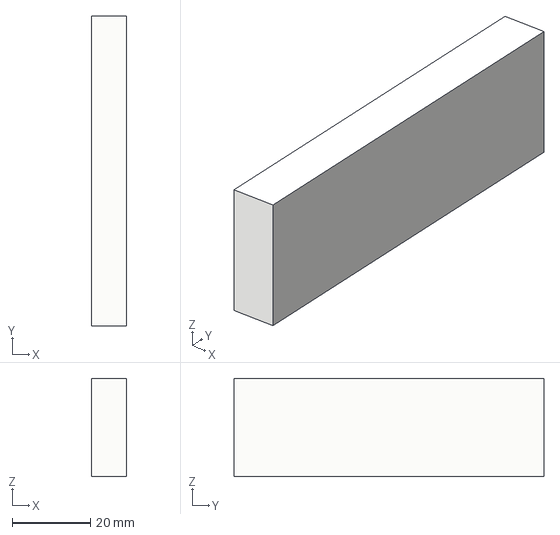
[picture p57: CAD file, 2026-11-12]
3D Models/Widow/Reference Parts/camera-luxonis-oak-d-pro-heatsink.step
8.87 x 79.0 x 25.0 mm
