LiDRON7/Drone-Construction/3D Models/Widow/Reference Parts/radio-telemetry-sik-v3-915mhz.step

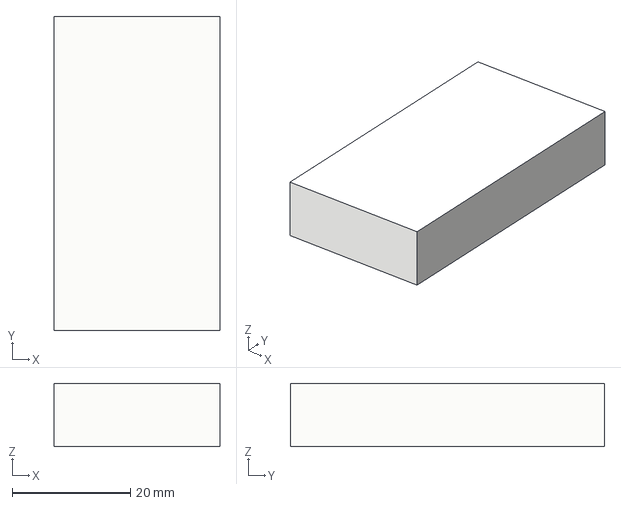
[picture p58: CAD file, 2026-11-12]
3D Models/Widow/Reference Parts/radio-telemetry-sik-v3-915mhz.step
28.0 x 53.0 x 10.7 mm
