LiDRON7/Drone-Construction/3D Models/Widow/Reference Parts/computer-raspberry-pi-5-with-cooler.step

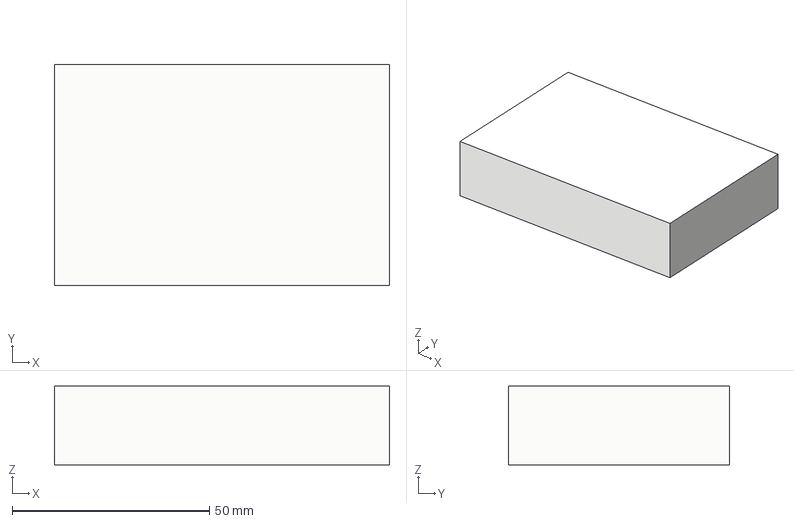
[picture p59: CAD file, 2026-11-12]
3D Models/Widow/Reference Parts/computer-raspberry-pi-5-with-cooler.step
85.0 x 56.0 x 20.0 mm
