LiDRON7/Drone-Construction/3D Models/Widow/Reference Parts/power-module-holybro-pm02d.step

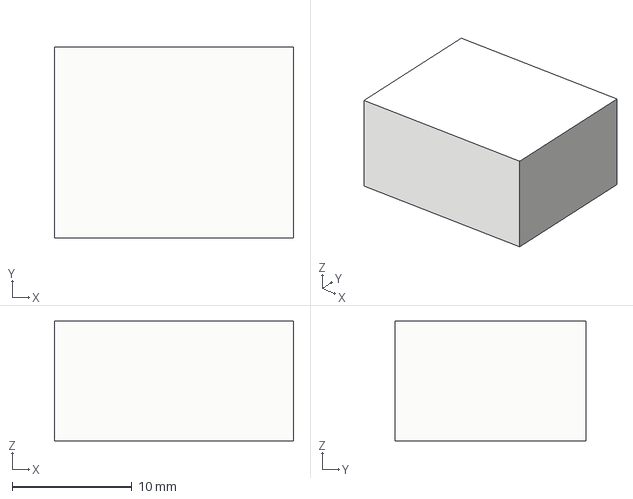
[picture p60: CAD file, 2026-11-12]
3D Models/Widow/Reference Parts/power-module-holybro-pm02d.step
20.0 x 16.0 x 10.0 mm
