LiDRON7/Drone-Construction/3D Models/Widow/Reference Parts/gps-h-rtk-f9p-helical-antenna.step

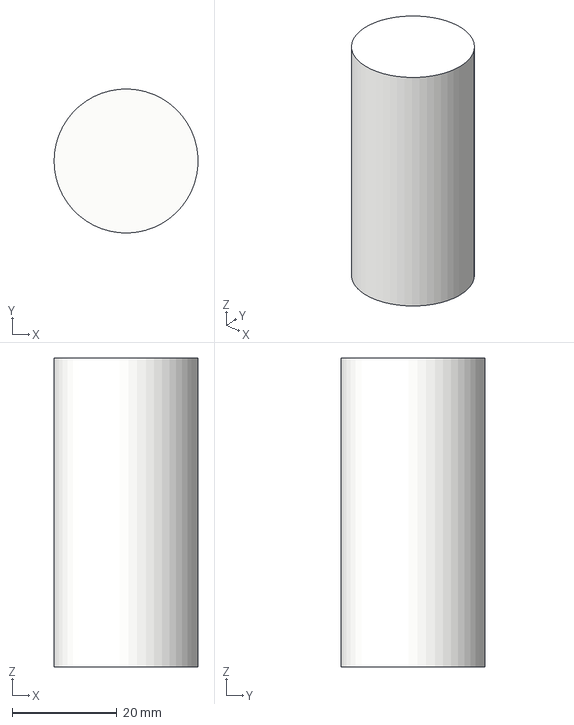
[picture p61: CAD file, 2026-11-12]
3D Models/Widow/Reference Parts/gps-h-rtk-f9p-helical-antenna.step
27.5 x 27.5 x 59.0 mm
