LiDRON7/Drone-Construction/3D Models/Widow/Reference Parts/propulsion-motor-storm-m2208.step

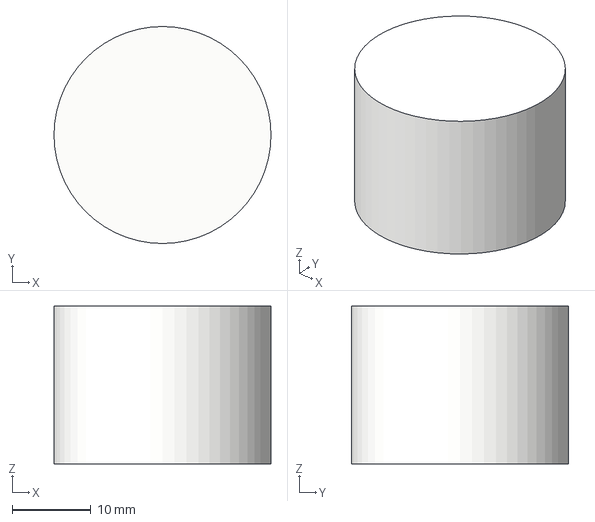
[picture p62: CAD file, 2026-11-12]
3D Models/Widow/Reference Parts/propulsion-motor-storm-m2208.step
27.5 x 27.5 x 20.0 mm
