LiDRON7/Drone-Construction/3D Models/Widow/Reference Parts/radio-rc-receiver-radiolink-r9ds.step

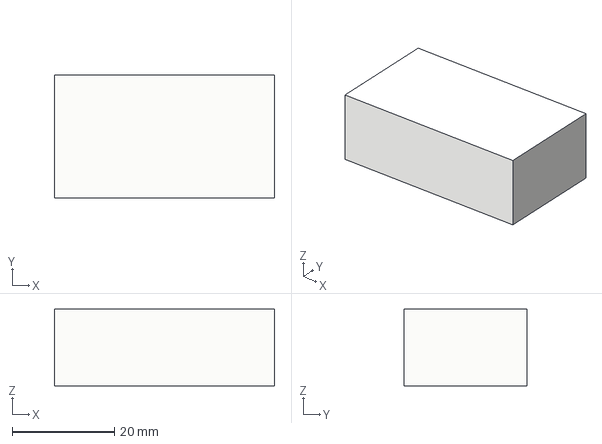
[picture p63: CAD file, 2026-11-12]
3D Models/Widow/Reference Parts/radio-rc-receiver-radiolink-r9ds.step
43.0 x 24.0 x 15.0 mm
