LiDRON7/Drone-Construction/3D Models/Widow/Reference Parts/frame-landing-leg-tube.step

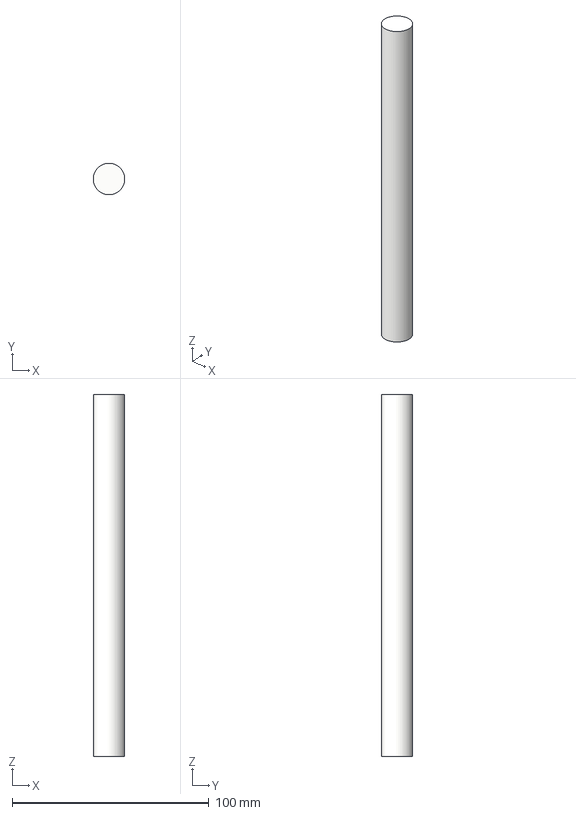
[picture p64: CAD file, 2026-11-10]
3D Models/Widow/Reference Parts/frame-landing-leg-tube.step
16.0 x 16.0 x 183.8 mm
