LiDRON7/Drone-Construction/3D Models/Widow/Reference Parts/frame-landing-skid-tube.step

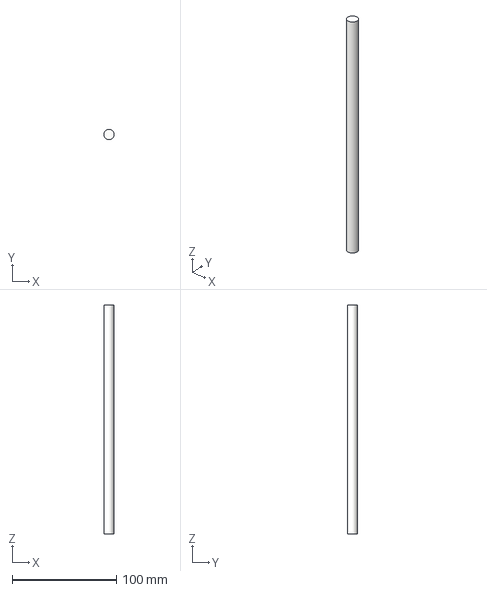
[picture p65: CAD file, 2026-11-10]
3D Models/Widow/Reference Parts/frame-landing-skid-tube.step
9.99 x 10.00 x 220.0 mm
