LiDRON7/Drone-Construction/3D Models/Widow/Reference Parts/flight-controller-foam-mount.step

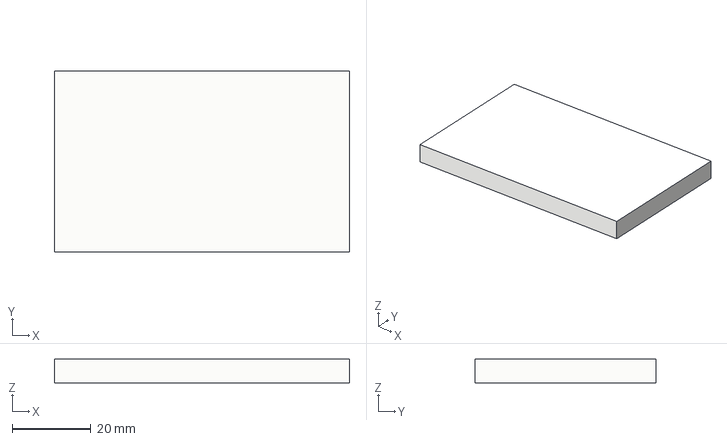
[picture p66: CAD file, 2026-11-10]
3D Models/Widow/Reference Parts/flight-controller-foam-mount.step
75.0 x 46.0 x 6.00 mm
