LiDRON7/Drone-Construction/3D Models/Widow/Reference Parts/flight-controller-pixhawk-6x-mini-fmu.step

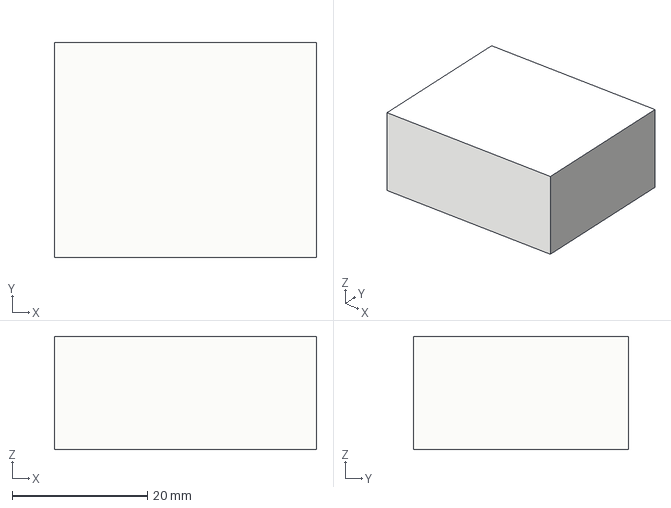
[picture p67: CAD file, 2026-11-10]
3D Models/Widow/Reference Parts/flight-controller-pixhawk-6x-mini-fmu.step
38.8 x 31.8 x 16.8 mm
