LiDRON7/Drone-Construction/3D Models/Widow/Reference Parts/propulsion-esc-f35a.step

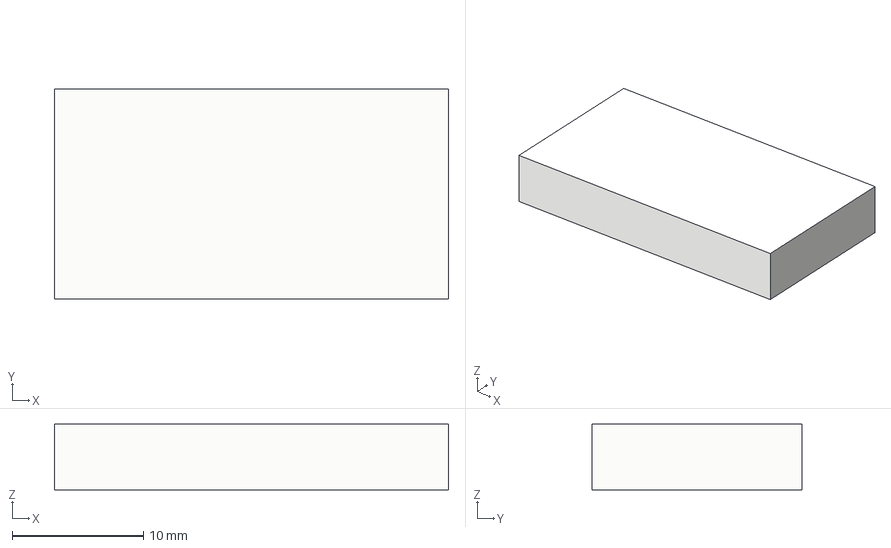
[picture p68: CAD file, 2026-11-10]
3D Models/Widow/Reference Parts/propulsion-esc-f35a.step
30.0 x 16.0 x 5.00 mm
