LiDRON7/Drone-Construction/3D Models/Widow/Reference Parts/gps-h-rtk-f9p-helical-module.step

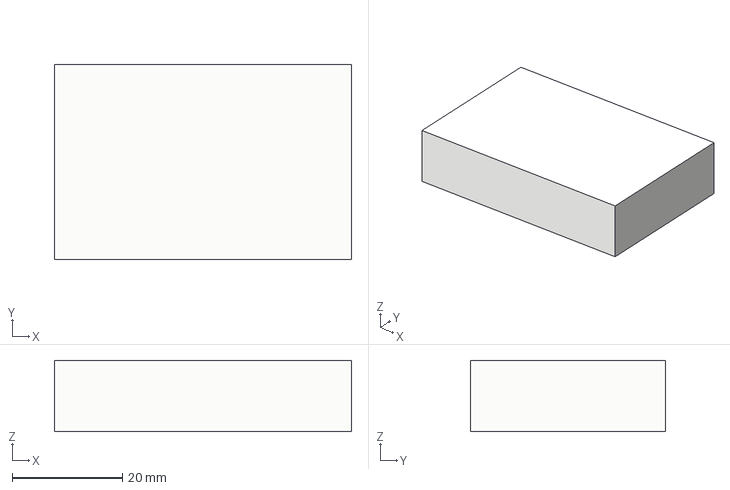
[picture p69: CAD file, 2026-11-10]
3D Models/Widow/Reference Parts/gps-h-rtk-f9p-helical-module.step
53.9 x 35.3 x 12.9 mm
