LiDRON7/Drone-Construction/3D Models/Widow/Reference Parts/camera-luxonis-oak-d-pro.step

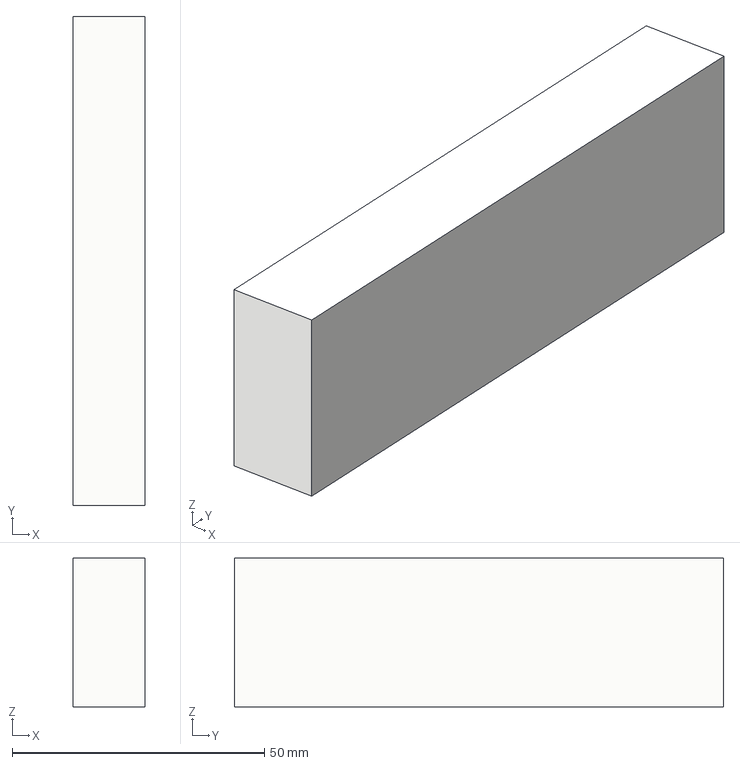
[picture p70: CAD file, 2026-11-10]
3D Models/Widow/Reference Parts/camera-luxonis-oak-d-pro.step
14.3 x 97.0 x 29.4 mm
