LiDRON7/Drone-Construction/3D Models/Widow/Reference Parts/power-step-down-5v.step

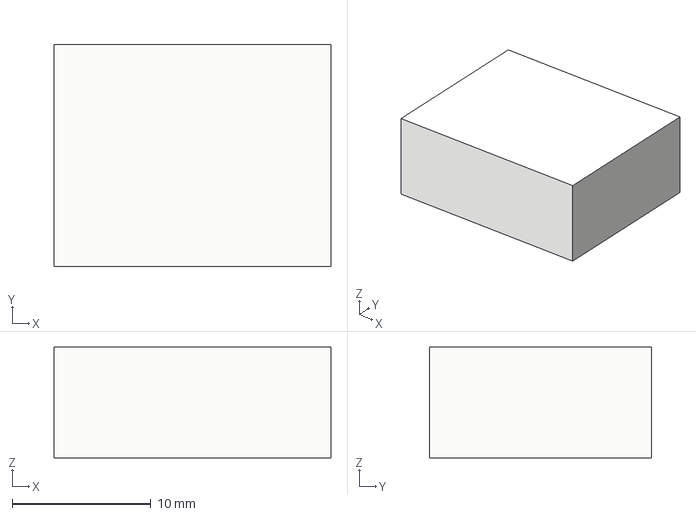
[picture p71: CAD file, 2026-11-10]
3D Models/Widow/Reference Parts/power-step-down-5v.step
20.0 x 16.0 x 8.00 mm
