LiDRON7/Drone-Construction/3D Models/Widow/Reference Parts/propulsion-propeller-8x4.5.stl

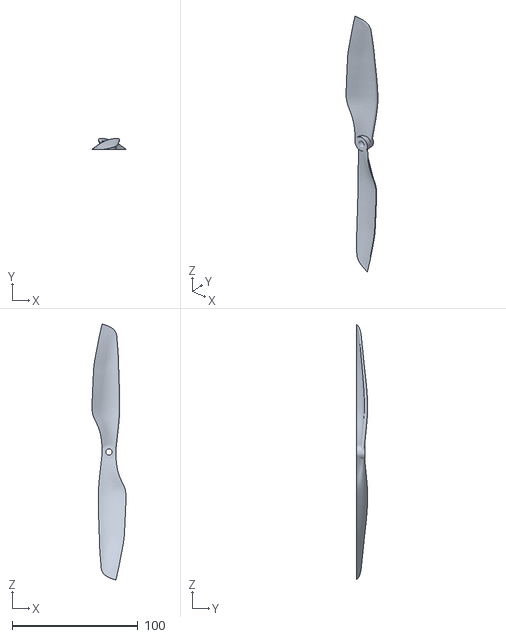
[picture p72: CAD file, 2026-11-07]
3D Models/Widow/Reference Parts/propulsion-propeller-8x4.5.stl
27.0 x 9.00 x 203.2
