LiDRON7/Drone-Construction/3D Models/Widow/Reference Parts/misc-battery-tray-placeholder.step

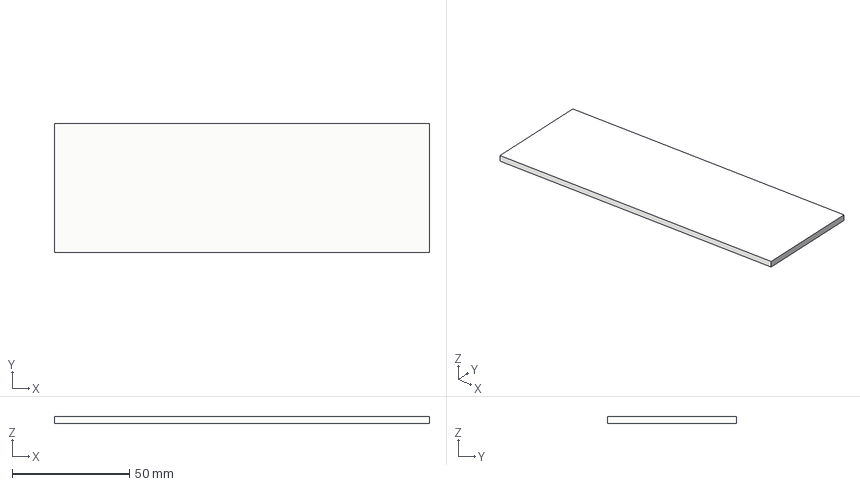
[picture p73: CAD file, 2026-11-07]
3D Models/Widow/Reference Parts/misc-battery-tray-placeholder.step
160.0 x 55.0 x 3.00 mm
