LiDRON7/Drone-Construction/(list of files, cad)

Other CAD files:
3D Models/Widow/Printed Parts/GPS Mast/gps-mast.step
3D Models/Widow/Printed Parts/Propeller Guard/propeller-guard.gcode.3mf
3D Models/Huntsman/Printed Parts/Propeller Guard/propeller-guard-right.stl
3D Models/Huntsman/Printed Parts/Propeller Guard/propeller-guard-right.gcode.3mf
3D Models/Huntsman/Printed Parts/Rain Cover/rain-canopy.step
3D Models/Widow/Printed Parts/Rain Cover/antenna-collar.step
3D Models/Widow/Printed Parts/Rain Cover/rain-canopy.gcode.3mf
3D Models/Widow/Reference Parts/frame-bottom-plate.step
3D Models/Huntsman/Full Drone/huntsman-full-drone.f3d
3D Models/Huntsman/Printed Parts/Payload Carrier/lidar-strap.stl
3D Models/Huntsman/Printed Parts/Payload Carrier/payload-carrier.3mf
3D Models/Huntsman/Printed Parts/Payload Carrier/payload-carrier.stl
3D Models/Huntsman/Printed Parts/Payload Carrier/rod-clamp.stl
3D Models/Huntsman/Printed Parts/Propeller Guard/arm-clamp.stl
3D Models/Huntsman/Printed Parts/Propeller Guard/propeller-guard.3mf
3D Models/Huntsman/Printed Parts/Propeller Guard/propeller-guard.stl
3D Models/Huntsman/Printed Parts/Rain Cover/esc-cover.stl
3D Models/Huntsman/Printed Parts/Rain Cover/interface-box-cover.stl
3D Models/Huntsman/Printed Parts/Rain Cover/motor-cap.stl
3D Models/Huntsman/Printed Parts/Rain Cover/rain-canopy.stl
3D Models/Widow/Full Drone/widow-full-drone.f3d
3D Models/Widow/Full Drone/widow-full-drone.stl
3D Models/Widow/Printed Parts/GPS Mast/gps-mast.3mf
3D Models/Widow/Printed Parts/GPS Mast/gps-mast.stl
3D Models/Widow/Printed Parts/Landing Leg/landing-leg-foot.stl
3D Models/Widow/Printed Parts/Landing Leg/landing-leg-mount.stl
3D Models/Widow/Printed Parts/Landing Leg/landing-leg.3mf
3D Models/Widow/Printed Parts/Propeller Guard/propeller-guard.3mf
3D Models/Widow/Printed Parts/Propeller Guard/propeller-guard.stl
3D Models/Widow/Printed Parts/Rain Cover/antenna-collar.stl
3D Models/Widow/Printed Parts/Rain Cover/camera-visor.stl
3D Models/Widow/Printed Parts/Rain Cover/esc-cover.stl
3D Models/Widow/Printed Parts/Rain Cover/motor-cap.stl
3D Models/Widow/Printed Parts/Rain Cover/rain-canopy.stl
3D Models/Widow/Reference Parts/camera-luxonis-oak-d-pro-heatsink.stl
3D Models/Widow/Reference Parts/camera-luxonis-oak-d-pro.stl
3D Models/Widow/Reference Parts/computer-raspberry-pi-5-with-cooler.stl
3D Models/Widow/Reference Parts/flight-controller-pixhawk-6x-mini-baseboard.stl
3D Models/Widow/Reference Parts/flight-controller-pixhawk-6x-mini-fmu.stl
3D Models/Widow/Reference Parts/frame-arm.stl
3D Models/Widow/Reference Parts/frame-battery-plate.stl
3D Models/Widow/Reference Parts/frame-landing-leg-tube.stl
3D Models/Widow/Reference Parts/frame-top-plate.stl
3D Models/Widow/Reference Parts/gps-h-rtk-f9p-helical-antenna.stl
3D Models/Widow/Reference Parts/gps-h-rtk-f9p-helical-module.stl
3D Models/Widow/Reference Parts/gps-metal-stand-base.stl
3D Models/Widow/Reference Parts/gps-metal-stand-rod.stl
3D Models/Widow/Reference Parts/power-battery-3s-5500mah-lipo.stl
3D Models/Widow/Reference Parts/propulsion-esc-f35a.stl
3D Models/Widow/Reference Parts/radio-rc-receiver-radiolink-r9ds.stl
