LiDRON7/Drone-Construction/(commit log)

2026-11-07 added widow 3d models: prop guards, landing legs, gps mast and full drone assembly
2026-11-09 legs under arms 3 and 6 with camera cradle on the leg mount, m2.5 inserts, slimmer gps mast, widow readme
2026-11-10 added huntsman payload carrier for the puck lite, battery and camera, huntsman prop guards and full drone model, widow leg mount pockets for the battery plate screws
2026-11-10 lidar turned to scan front to back with a strap round its top cap, cameras tilted 10 degrees down on both drones
2026-11-12 resliced the parts for the bambu x2d and removed the old kobra print files
2026-11-12 huntsman prop guards go under the motors, pinch rod clamps, safety cord holes, payload parts in paht-cf, fea script and results
2026-11-12 widow prop guards in the huntsman style: lattice ring with a top lip, t struts with wide roots, fins, checked with fea
2026-11-12 rain covers for both drones: canopy, antenna collar, camera visor, esc covers, motor caps, interface box cover
2026-11-12 full drone scripts write the weights, rotors, sensors and skids for the simulator
2026-11-13 huntsman checks: lidar ground strip is just its width, the along-track number was nonsense past 90 deg
2026-11-13 dropped the rain covers and the printed gps mast, gps goes on the metal stand 170 mm up
